pbozeman/artix-unplugged/README.md

# Artix Unplugged

Bare Artix-7 with all the IO pins exposed.
