pbozeman/artix-unplugged/docs/programming.md

# Programming

## Flash

Supported flash memory: see <https://docs.amd.com/r/en-US/ug908-vivado-programming-debugging/Artix-7-Configuration-Memory-Devices>

> Decision: MX25L3233F
