pbozeman/artix-unplugged/pcb/aup/aup.kicad_pcb

## KiCad design pcb/aup/aup.kicad_pcb (2025-06-10)

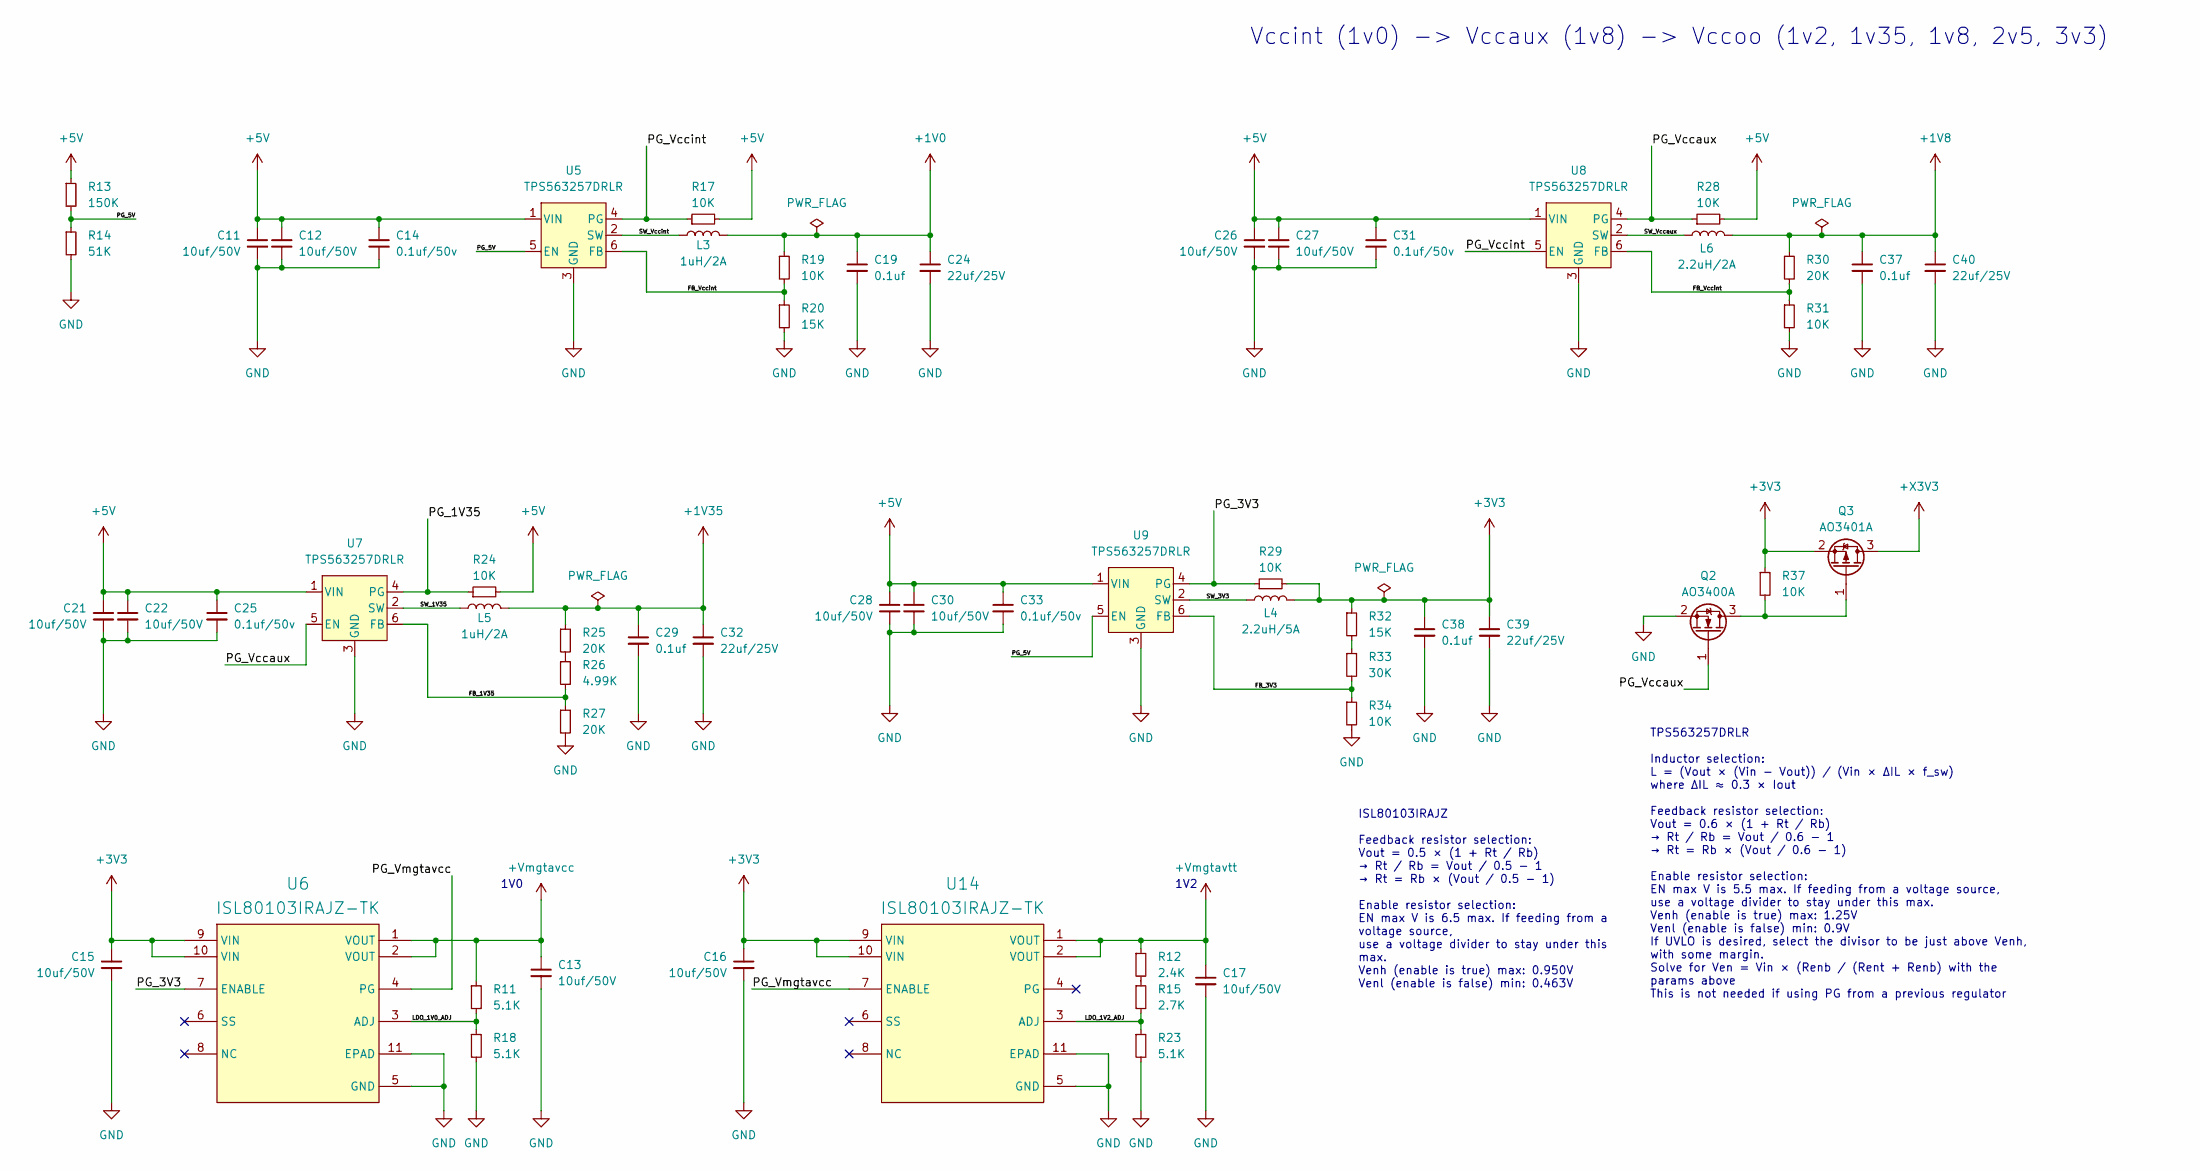
[picture p1: schematic power_reg.kicad_sch, Power Regulation]

Parts:
C11, C12, C13, C15, C16, C17, C21, C22, C26, C27, C28, C30: 10uf/50V; C_0805_2012Metric; LCSC Part # C440198
C14, C25, C31, C33: 0.1uf/50v; C_0603_1608Metric; LCSC Part # C14663
C19, C29, C37, C38: 0.1uf; C_0402_1005Metric; LCSC Part # C1525
C24, C32, C39, C40: 22uf/25V; C_0805_2012Metric; LCSC Part # C45783
L3, L5: 1uH/2A; L_1008_2520Metric; LCSC Part # C435392
L4: 2.2uH/5A; L_Sunlord_MWSA0518S; LCSC Part # C408345
L6: 2.2uH/2A; L_1008_2520Metric; LCSC Part # C576403
Q2: AO3400A; SOT-23; LCSC Part # C20917
Q3: AO3401A; SOT-23; LCSC Part # C15127
R11, R18, R23: 5.1K; R_0603_1608Metric; LCSC Part # C23186
R12: 2.4K; R_0603_1608Metric; LCSC Part # C22940
R13: 150K; R_0603_1608Metric; LCSC Part # C22808
R14: 51K; R_0603_1608Metric; LCSC Part # C23196
R15: 2.7K; R_0603_1608Metric; LCSC Part # C25879
R17, R19, R24, R28, R29, R31, R34, R37: 10K; R_0603_1608Metric; LCSC Part # C25804
R20, R32: 15K; R_0603_1608Metric; LCSC Part # C22809
R25, R27, R30: 20K; R_0603_1608Metric; LCSC Part # C4184
R26: 4.99K; R_0603_1608Metric; LCSC Part # C23046
R33: 30K; R_0603_1608Metric; LCSC Part # C22984
U5, U7, U8, U9: TPS563257DRLR; SOT6_DRL_TEX; LCSC Part # C20539656
U6, U14: ISL80103IRAJZ-TK; DFN10_3X3_INR; LCSC Part # C382020

Connections:
+1V0: C19.1, C24.1, L3.2, R19.1; also elsewhere on the board
+1V8: C37.1, C40.1, L6.2, R30.1; also elsewhere on the board
+1V35: C29.1, C32.1, L5.2, R25.1; also elsewhere on the board
+3V3: C15.1, C16.1, C38.1, C39.1, L4.2, Q3.2 (S), R29.2, R32.1, R37.1, U6.9 (VIN), U6.10 (VIN), U14.9 (VIN), U14.10 (VIN); also elsewhere on the board
+5V: C11.1, C12.1, C14.1, C21.1, C22.1, C25.1, C26.1, C27.1, C28.1, C30.1, C31.1, C33.1, R13.1, R17.2, R24.2, R28.2, U5.1 (VIN), U7.1 (VIN), U8.1 (VIN), U9.1 (VIN); also elsewhere on the board
+Vmgtavcc: C13.1, R11.1, U6.1 (VOUT), U6.2 (VOUT); also elsewhere on the board
+Vmgtavtt: C17.1, R12.1, U14.1 (VOUT), U14.2 (VOUT); also elsewhere on the board
+X3V3: Q3.3 (D)
/power_reg/FB_1V35: R26.2, R27.1, U7.6 (FB)
/power_reg/FB_3V3: R33.2, R34.1, U9.6 (FB)
/power_reg/FB_Vccint: R19.2, R20.1, R30.2, R31.1, U5.6 (FB), U8.6 (FB)
/power_reg/LDO_1V0_ADJ: R11.2, R18.1, U6.3 (ADJ)
/power_reg/LDO_1V2_ADJ: R15.2, R23.1, U14.3 (ADJ)
/power_reg/PG_1V35: R24.1, U7.4 (PG)
/power_reg/PG_3V3: R29.1, U6.7 (ENABLE), U9.4 (PG)
/power_reg/PG_5V: R13.2, R14.1, U5.5 (EN), U9.5 (EN)
/power_reg/PG_Vccaux: Q2.1 (G), R28.1, U7.5 (EN), U8.4 (PG)
/power_reg/PG_Vccint: R17.1, U5.4 (PG), U8.5 (EN)
/power_reg/PG_Vmgtavcc: U6.4 (PG), U14.7 (ENABLE)
/power_reg/SW_1V35: L5.1, U7.2 (SW)
/power_reg/SW_3V3: L4.1, U9.2 (SW)
/power_reg/SW_Vccaux: L6.1, U8.2 (SW)
/power_reg/SW_Vccint: L3.1, U5.2 (SW)
GND: C11.2, C12.2, C13.2, C14.2, C15.2, C16.2, C17.2, C19.2, C21.2, C22.2, C24.2, C25.2, C26.2, C27.2, C28.2, C29.2, C30.2, C31.2, C32.2, C33.2, C37.2, C38.2, C39.2, C40.2, Q2.2 (S), R14.2, R18.2, R20.2, R23.2, R27.2, R31.2, R34.2, U5.3 (GND), U6.5 (GND), U6.11 (EPAD), U7.3 (GND), U8.3 (GND), U9.3 (GND), U14.5 (GND), U14.11 (EPAD); also elsewhere on the board
unnamed: Q2.3 (D), Q3.1 (G), R37.2
unnamed: R12.2, R15.1
unnamed: R25.2, R26.1
unnamed: R32.2, R33.1

Notes on the sheet:
Vccint (1v0) -> Vccaux (1v8) -> Vccoo (1v2, 1v35, 1v8, 2v5, 3v3)
1V2
1V0
TPS563257DRLR Inductor selection: L = (Vout × (Vin - Vout)) / (Vin × ΔIL × f_sw) where ΔIL ≈ 0.3 × Iout Feedback resistor selection: Vout = 0.6 × (1 + Rt / Rb) → Rt / Rb = Vout / 0.6 - 1 → Rt = Rb × (Vout / 0.6 - 1) Enable resistor selection: EN max V is 5.5 max. If feeding from a voltage source, u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
ISL80103IRAJZ Feedback resistor selection: Vout = 0.5 × (1 + Rt / Rb) → Rt / Rb = Vout / 0.5 - 1 → Rt = Rb × (Vout / 0.5 - 1) Enable resistor selection: EN max V is 6.5 max. If feeding from a voltage source, use a voltage divider to stay under this max. Venh (enable is true) max: 0.950V Venl (enabl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

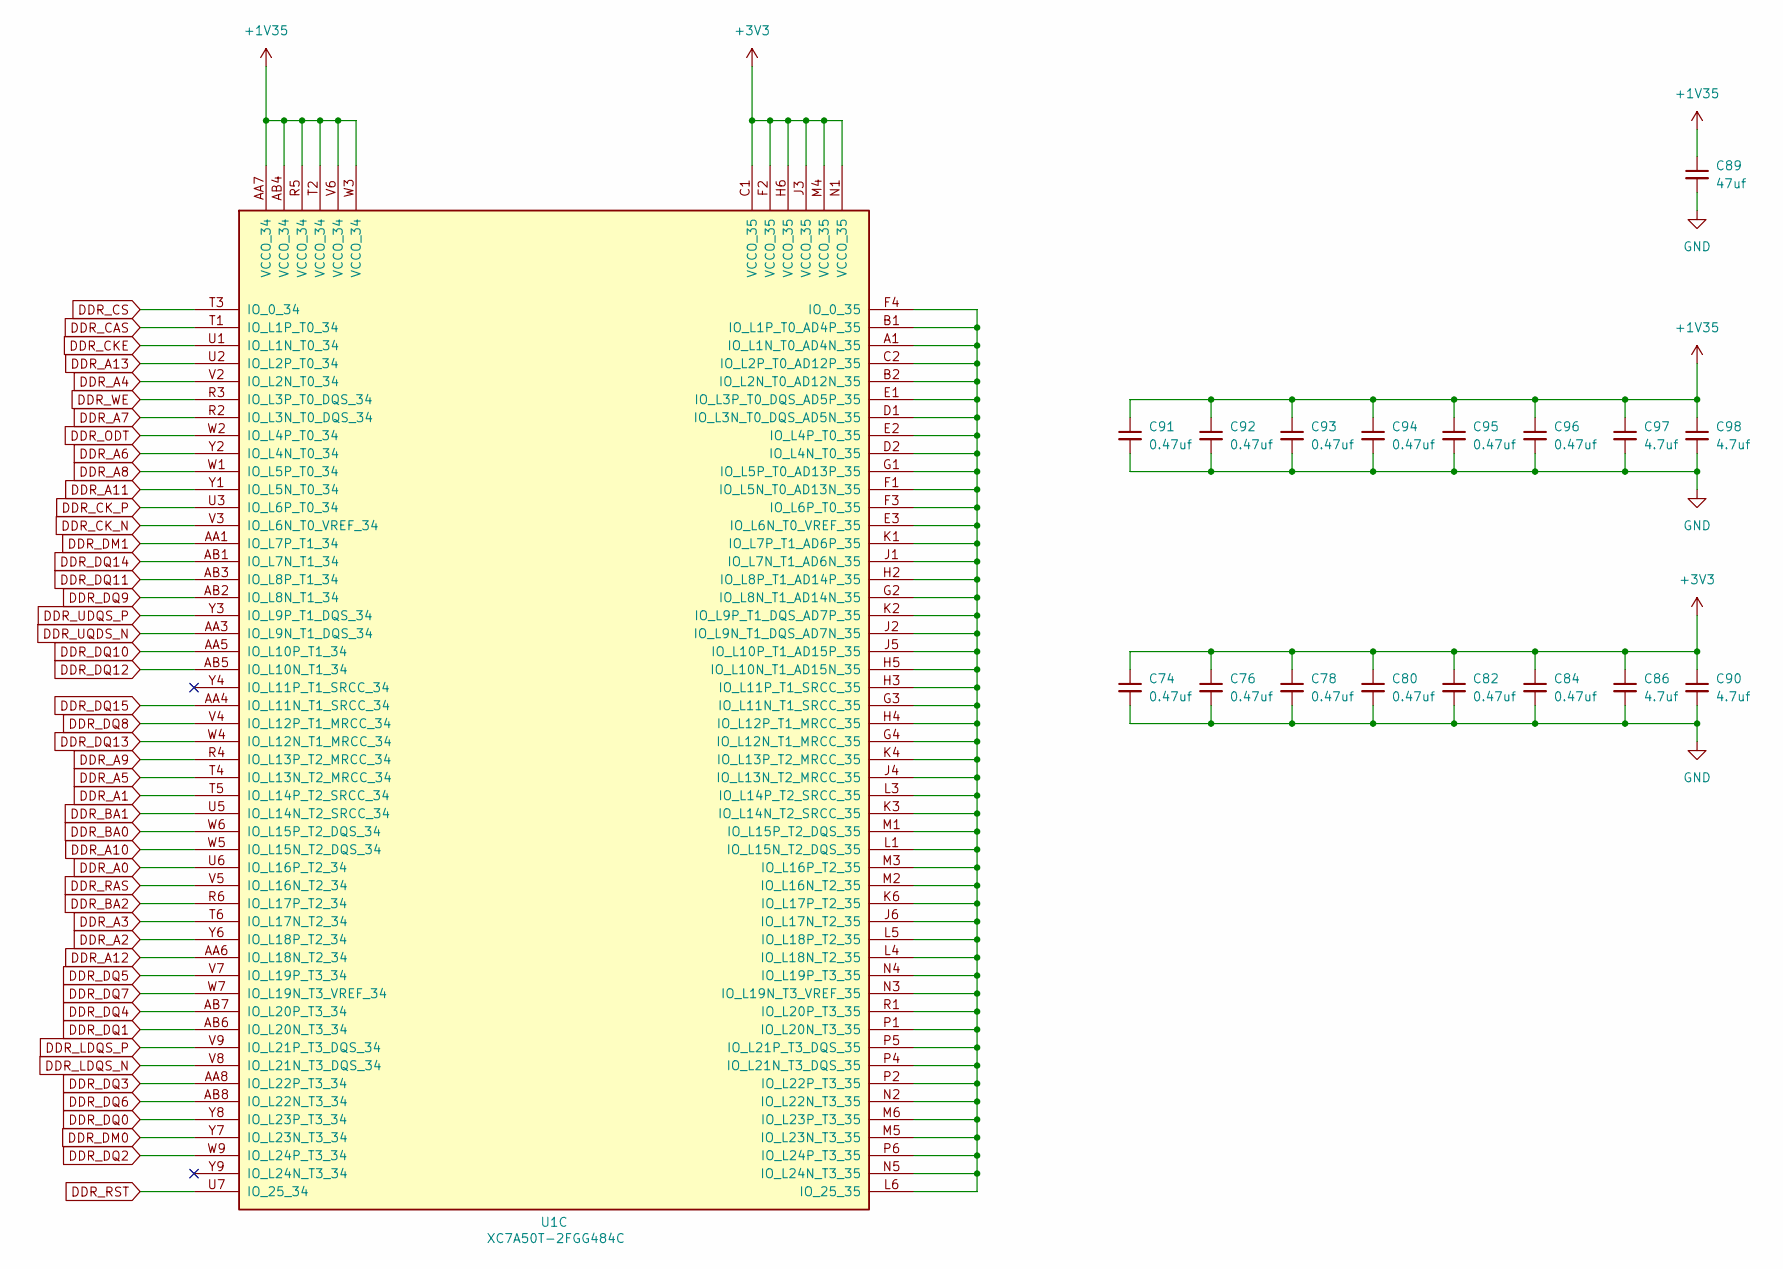
[picture p2: schematic fpga_banks_34_35.kicad_sch]

Parts:
C74, C76, C78, C80, C82, C84, C91, C92, C93, C94, C95, C96: 0.47uf; C_0201_0603Metric; LCSC Part # C318543
C86, C90, C97, C98: 4.7uf; C_0805_2012Metric; LCSC Part # C1779
C89: 47uf; C_1206_3216Metric; LCSC Part # C96123
U1: XC7A50T-2FGG484C; Xilinx_FGG484; LCSC Part # C1550658

Connections:
+1V35: C89.1, C91.1, C92.1, C93.1, C94.1, C95.1, C96.1, C97.1, C98.1, U1.AA7 (VCCO_34), U1.AB4 (VCCO_34), U1.R5 (VCCO_34), U1.T2 (VCCO_34), U1.V6 (VCCO_34), U1.W3 (VCCO_34); also elsewhere on the board
+3V3: C74.1, C76.1, C78.1, C80.1, C82.1, C84.1, C86.1, C90.1, U1.C1 (VCCO_35), U1.F2 (VCCO_35), U1.H6 (VCCO_35), U1.J3 (VCCO_35), U1.M4 (VCCO_35), U1.N1 (VCCO_35); also elsewhere on the board
DDR_A0: U1.U6 (IO_L16P_T2_34); also elsewhere on the board
DDR_A1: U1.T5 (IO_L14P_T2_SRCC_34); also elsewhere on the board
DDR_A2: U1.Y6 (IO_L18P_T2_34); also elsewhere on the board
DDR_A3: U1.T6 (IO_L17N_T2_34); also elsewhere on the board
DDR_A4: U1.V2 (IO_L2N_T0_34); also elsewhere on the board
DDR_A5: U1.T4 (IO_L13N_T2_MRCC_34); also elsewhere on the board
DDR_A6: U1.Y2 (IO_L4N_T0_34); also elsewhere on the board
DDR_A7: U1.R2 (IO_L3N_T0_DQS_34); also elsewhere on the board
DDR_A8: U1.W1 (IO_L5P_T0_34); also elsewhere on the board
DDR_A9: U1.R4 (IO_L13P_T2_MRCC_34); also elsewhere on the board
DDR_A10: U1.W5 (IO_L15N_T2_DQS_34); also elsewhere on the board
DDR_A11: U1.Y1 (IO_L5N_T0_34); also elsewhere on the board
DDR_A12: U1.AA6 (IO_L18N_T2_34); also elsewhere on the board
DDR_A13: U1.U2 (IO_L2P_T0_34); also elsewhere on the board
DDR_BA0: U1.W6 (IO_L15P_T2_DQS_34); also elsewhere on the board
DDR_BA1: U1.U5 (IO_L14N_T2_SRCC_34); also elsewhere on the board
DDR_BA2: U1.R6 (IO_L17P_T2_34); also elsewhere on the board
DDR_CAS: U1.T1 (IO_L1P_T0_34); also elsewhere on the board
DDR_CKE: U1.U1 (IO_L1N_T0_34); also elsewhere on the board
DDR_CK_N: U1.V3 (IO_L6N_T0_VREF_34); also elsewhere on the board
DDR_CK_P: U1.U3 (IO_L6P_T0_34); also elsewhere on the board
DDR_CS: U1.T3 (IO_0_34); also elsewhere on the board
DDR_DM0: U1.Y7 (IO_L23N_T3_34); also elsewhere on the board
DDR_DM1: U1.AA1 (IO_L7P_T1_34); also elsewhere on the board
DDR_DQ0: U1.Y8 (IO_L23P_T3_34); also elsewhere on the board
DDR_DQ1: U1.AB6 (IO_L20N_T3_34); also elsewhere on the board
DDR_DQ2: U1.W9 (IO_L24P_T3_34); also elsewhere on the board
DDR_DQ3: U1.AA8 (IO_L22P_T3_34); also elsewhere on the board
DDR_DQ4: U1.AB7 (IO_L20P_T3_34); also elsewhere on the board
DDR_DQ5: U1.V7 (IO_L19P_T3_34); also elsewhere on the board
DDR_DQ6: U1.AB8 (IO_L22N_T3_34); also elsewhere on the board
DDR_DQ7: U1.W7 (IO_L19N_T3_VREF_34); also elsewhere on the board
DDR_DQ8: U1.V4 (IO_L12P_T1_MRCC_34); also elsewhere on the board
DDR_DQ9: U1.AB2 (IO_L8N_T1_34); also elsewhere on the board
DDR_DQ10: U1.AA5 (IO_L10P_T1_34); also elsewhere on the board
DDR_DQ11: U1.AB3 (IO_L8P_T1_34); also elsewhere on the board
DDR_DQ12: U1.AB5 (IO_L10N_T1_34); also elsewhere on the board
DDR_DQ13: U1.W4 (IO_L12N_T1_MRCC_34); also elsewhere on the board
DDR_DQ14: U1.AB1 (IO_L7N_T1_34); also elsewhere on the board
DDR_DQ15: U1.AA4 (IO_L11N_T1_SRCC_34); also elsewhere on the board
DDR_LDQS_N: U1.V8 (IO_L21N_T3_DQS_34); also elsewhere on the board
DDR_LDQS_P: U1.V9 (IO_L21P_T3_DQS_34); also elsewhere on the board
DDR_ODT: U1.W2 (IO_L4P_T0_34); also elsewhere on the board
DDR_RAS: U1.V5 (IO_L16N_T2_34); also elsewhere on the board
DDR_RST: U1.U7 (IO_25_34); also elsewhere on the board
DDR_UDQS_P: U1.Y3 (IO_L9P_T1_DQS_34); also elsewhere on the board
DDR_UQDS_N: U1.AA3 (IO_L9N_T1_DQS_34); also elsewhere on the board
DDR_WE: U1.R3 (IO_L3P_T0_DQS_34); also elsewhere on the board
GND: C74.2, C76.2, C78.2, C80.2, C82.2, C84.2, C86.2, C89.2, C90.2, C91.2, C92.2, C93.2, C94.2, C95.2, C96.2, C97.2, C98.2; also elsewhere on the board
unnamed: U1.A1 (IO_L1N_T0_AD4N_35), U1.B1 (IO_L1P_T0_AD4P_35), U1.B2 (IO_L2N_T0_AD12N_35), U1.C2 (IO_L2P_T0_AD12P_35), U1.D1 (IO_L3N_T0_DQS_AD5N_35), U1.D2 (IO_L4N_T0_35), U1.E1 (IO_L3P_T0_DQS_AD5P_35), U1.E2 (IO_L4P_T0_35), U1.E3 (IO_L6N_T0_VREF_35), U1.F1 (IO_L5N_T0_AD13N_35), U1.F3 (IO_L6P_T0_35), U1.F4 (IO_0_35), U1.G1 (IO_L5P_T0_AD13P_35), U1.G2 (IO_L8N_T1_AD14N_35), U1.G3 (IO_L11N_T1_SRCC_35), U1.G4 (IO_L12N_T1_MRCC_35), U1.H2 (IO_L8P_T1_AD14P_35), U1.H3 (IO_L11P_T1_SRCC_35), U1.H4 (IO_L12P_T1_MRCC_35), U1.H5 (IO_L10N_T1_AD15N_35), U1.J1 (IO_L7N_T1_AD6N_35), U1.J2 (IO_L9N_T1_DQS_AD7N_35), U1.J4 (IO_L13N_T2_MRCC_35), U1.J5 (IO_L10P_T1_AD15P_35), U1.J6 (IO_L17N_T2_35), U1.K1 (IO_L7P_T1_AD6P_35), U1.K2 (IO_L9P_T1_DQS_AD7P_35), U1.K3 (IO_L14N_T2_SRCC_35), U1.K4 (IO_L13P_T2_MRCC_35), U1.K6 (IO_L17P_T2_35), U1.L1 (IO_L15N_T2_DQS_35), U1.L3 (IO_L14P_T2_SRCC_35), U1.L4 (IO_L18N_T2_35), U1.L5 (IO_L18P_T2_35), U1.L6 (IO_25_35), U1.M1 (IO_L15P_T2_DQS_35), U1.M2 (IO_L16N_T2_35), U1.M3 (IO_L16P_T2_35), U1.M5 (IO_L23N_T3_35), U1.M6 (IO_L23P_T3_35), U1.N2 (IO_L22N_T3_35), U1.N3 (IO_L19N_T3_VREF_35), U1.N4 (IO_L19P_T3_35), U1.N5 (IO_L24N_T3_35), U1.P1 (IO_L20N_T3_35), U1.P2 (IO_L22P_T3_35), U1.P4 (IO_L21N_T3_DQS_35), U1.P5 (IO_L21P_T3_DQS_35), U1.P6 (IO_L24P_T3_35), U1.R1 (IO_L20P_T3_35)

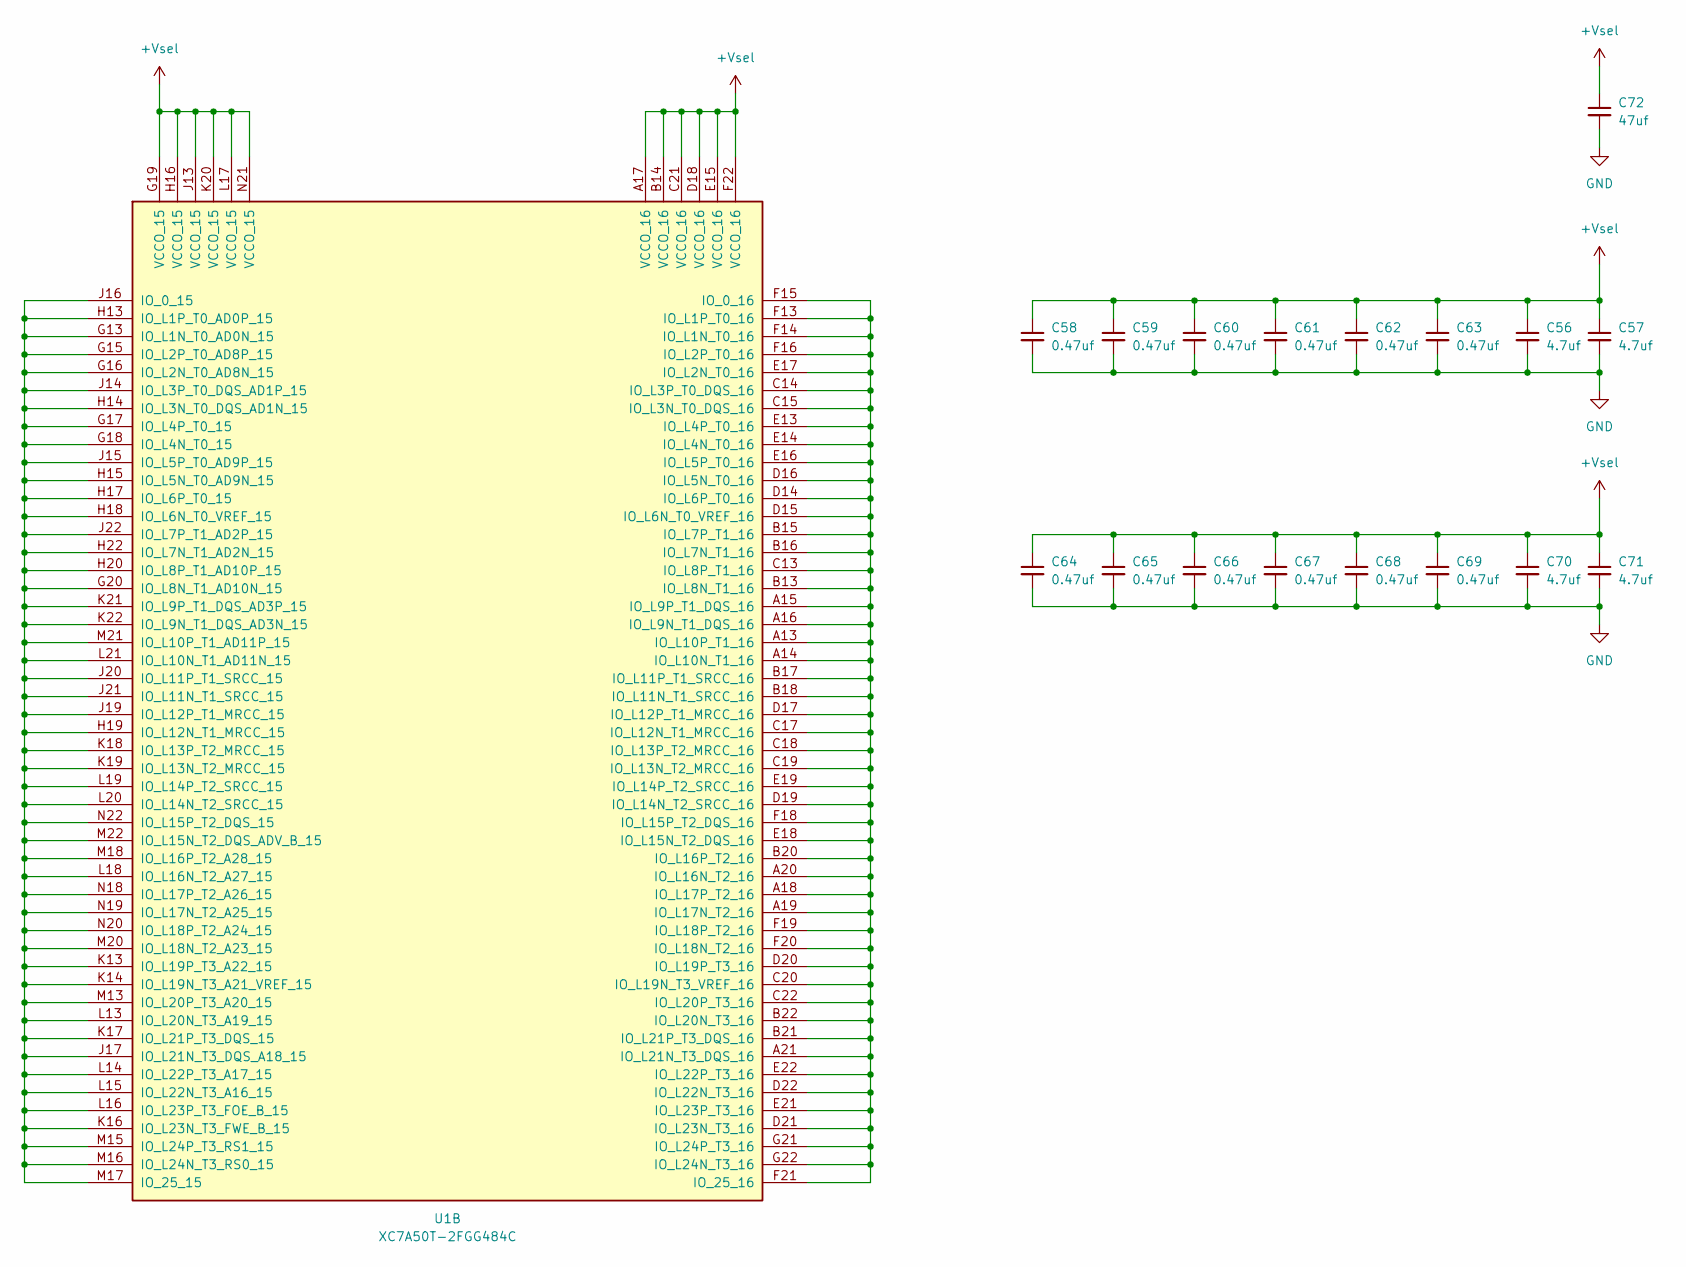
[picture p3: schematic fpga_banks_15_16_adj.kicad_sch]

Parts:
C56, C57, C70, C71: 4.7uf; C_0805_2012Metric; LCSC Part # C1779
C58, C59, C60, C61, C62, C63, C64, C65, C66, C67, C68, C69: 0.47uf; C_0201_0603Metric; LCSC Part # C318543
C72: 47uf; C_1206_3216Metric; LCSC Part # C96123
U1: XC7A50T-2FGG484C; Xilinx_FGG484; LCSC Part # C1550658

Connections:
+Vsel: C56.1, C57.1, C58.1, C59.1, C60.1, C61.1, C62.1, C63.1, C64.1, C65.1, C66.1, C67.1, C68.1, C69.1, C70.1, C71.1, C72.1, U1.A17 (VCCO_16), U1.B14 (VCCO_16), U1.C21 (VCCO_16), U1.D18 (VCCO_16), U1.E15 (VCCO_16), U1.F22 (VCCO_16), U1.G19 (VCCO_15), U1.H16 (VCCO_15), U1.J13 (VCCO_15), U1.K20 (VCCO_15), U1.L17 (VCCO_15), U1.N21 (VCCO_15); also elsewhere on the board
GND: C56.2, C57.2, C58.2, C59.2, C60.2, C61.2, C62.2, C63.2, C64.2, C65.2, C66.2, C67.2, C68.2, C69.2, C70.2, C71.2, C72.2; also elsewhere on the board
unnamed: U1.G13 (IO_L1N_T0_AD0N_15), U1.G15 (IO_L2P_T0_AD8P_15), U1.G16 (IO_L2N_T0_AD8N_15), U1.G17 (IO_L4P_T0_15), U1.G18 (IO_L4N_T0_15), U1.G20 (IO_L8N_T1_AD10N_15), U1.H13 (IO_L1P_T0_AD0P_15), U1.H14 (IO_L3N_T0_DQS_AD1N_15), U1.H15 (IO_L5N_T0_AD9N_15), U1.H17 (IO_L6P_T0_15), U1.H18 (IO_L6N_T0_VREF_15), U1.H19 (IO_L12N_T1_MRCC_15), U1.H20 (IO_L8P_T1_AD10P_15), U1.H22 (IO_L7N_T1_AD2N_15), U1.J14 (IO_L3P_T0_DQS_AD1P_15), U1.J15 (IO_L5P_T0_AD9P_15), U1.J16 (IO_0_15), U1.J17 (IO_L21N_T3_DQS_A18_15), U1.J19 (IO_L12P_T1_MRCC_15), U1.J20 (IO_L11P_T1_SRCC_15), U1.J21 (IO_L11N_T1_SRCC_15), U1.J22 (IO_L7P_T1_AD2P_15), U1.K13 (IO_L19P_T3_A22_15), U1.K14 (IO_L19N_T3_A21_VREF_15), U1.K16 (IO_L23N_T3_FWE_B_15), U1.K17 (IO_L21P_T3_DQS_15), U1.K18 (IO_L13P_T2_MRCC_15), U1.K19 (IO_L13N_T2_MRCC_15), U1.K21 (IO_L9P_T1_DQS_AD3P_15), U1.K22 (IO_L9N_T1_DQS_AD3N_15), U1.L13 (IO_L20N_T3_A19_15), U1.L14 (IO_L22P_T3_A17_15), U1.L15 (IO_L22N_T3_A16_15), U1.L16 (IO_L23P_T3_FOE_B_15), U1.L18 (IO_L16N_T2_A27_15), U1.L19 (IO_L14P_T2_SRCC_15), U1.L20 (IO_L14N_T2_SRCC_15), U1.L21 (IO_L10N_T1_AD11N_15), U1.M13 (IO_L20P_T3_A20_15), U1.M15 (IO_L24P_T3_RS1_15), U1.M16 (IO_L24N_T3_RS0_15), U1.M17 (IO_25_15), U1.M18 (IO_L16P_T2_A28_15), U1.M20 (IO_L18N_T2_A23_15), U1.M21 (IO_L10P_T1_AD11P_15), U1.M22 (IO_L15N_T2_DQS_ADV_B_15), U1.N18 (IO_L17P_T2_A26_15), U1.N19 (IO_L17N_T2_A25_15), U1.N20 (IO_L18P_T2_A24_15), U1.N22 (IO_L15P_T2_DQS_15)
unnamed: U1.A13 (IO_L10P_T1_16), U1.A14 (IO_L10N_T1_16), U1.A15 (IO_L9P_T1_DQS_16), U1.A16 (IO_L9N_T1_DQS_16), U1.A18 (IO_L17P_T2_16), U1.A19 (IO_L17N_T2_16), U1.A20 (IO_L16N_T2_16), U1.A21 (IO_L21N_T3_DQS_16), U1.B13 (IO_L8N_T1_16), U1.B15 (IO_L7P_T1_16), U1.B16 (IO_L7N_T1_16), U1.B17 (IO_L11P_T1_SRCC_16), U1.B18 (IO_L11N_T1_SRCC_16), U1.B20 (IO_L16P_T2_16), U1.B21 (IO_L21P_T3_DQS_16), U1.B22 (IO_L20N_T3_16), U1.C13 (IO_L8P_T1_16), U1.C14 (IO_L3P_T0_DQS_16), U1.C15 (IO_L3N_T0_DQS_16), U1.C17 (IO_L12N_T1_MRCC_16), U1.C18 (IO_L13P_T2_MRCC_16), U1.C19 (IO_L13N_T2_MRCC_16), U1.C20 (IO_L19N_T3_VREF_16), U1.C22 (IO_L20P_T3_16), U1.D14 (IO_L6P_T0_16), U1.D15 (IO_L6N_T0_VREF_16), U1.D16 (IO_L5N_T0_16), U1.D17 (IO_L12P_T1_MRCC_16), U1.D19 (IO_L14N_T2_SRCC_16), U1.D20 (IO_L19P_T3_16), U1.D21 (IO_L23N_T3_16), U1.D22 (IO_L22N_T3_16), U1.E13 (IO_L4P_T0_16), U1.E14 (IO_L4N_T0_16), U1.E16 (IO_L5P_T0_16), U1.E17 (IO_L2N_T0_16), U1.E18 (IO_L15N_T2_DQS_16), U1.E19 (IO_L14P_T2_SRCC_16), U1.E21 (IO_L23P_T3_16), U1.E22 (IO_L22P_T3_16), U1.F13 (IO_L1P_T0_16), U1.F14 (IO_L1N_T0_16), U1.F15 (IO_0_16), U1.F16 (IO_L2P_T0_16), U1.F18 (IO_L15P_T2_DQS_16), U1.F19 (IO_L18P_T2_16), U1.F20 (IO_L18N_T2_16), U1.F21 (IO_25_16), U1.G21 (IO_L24P_T3_16), U1.G22 (IO_L24N_T3_16)

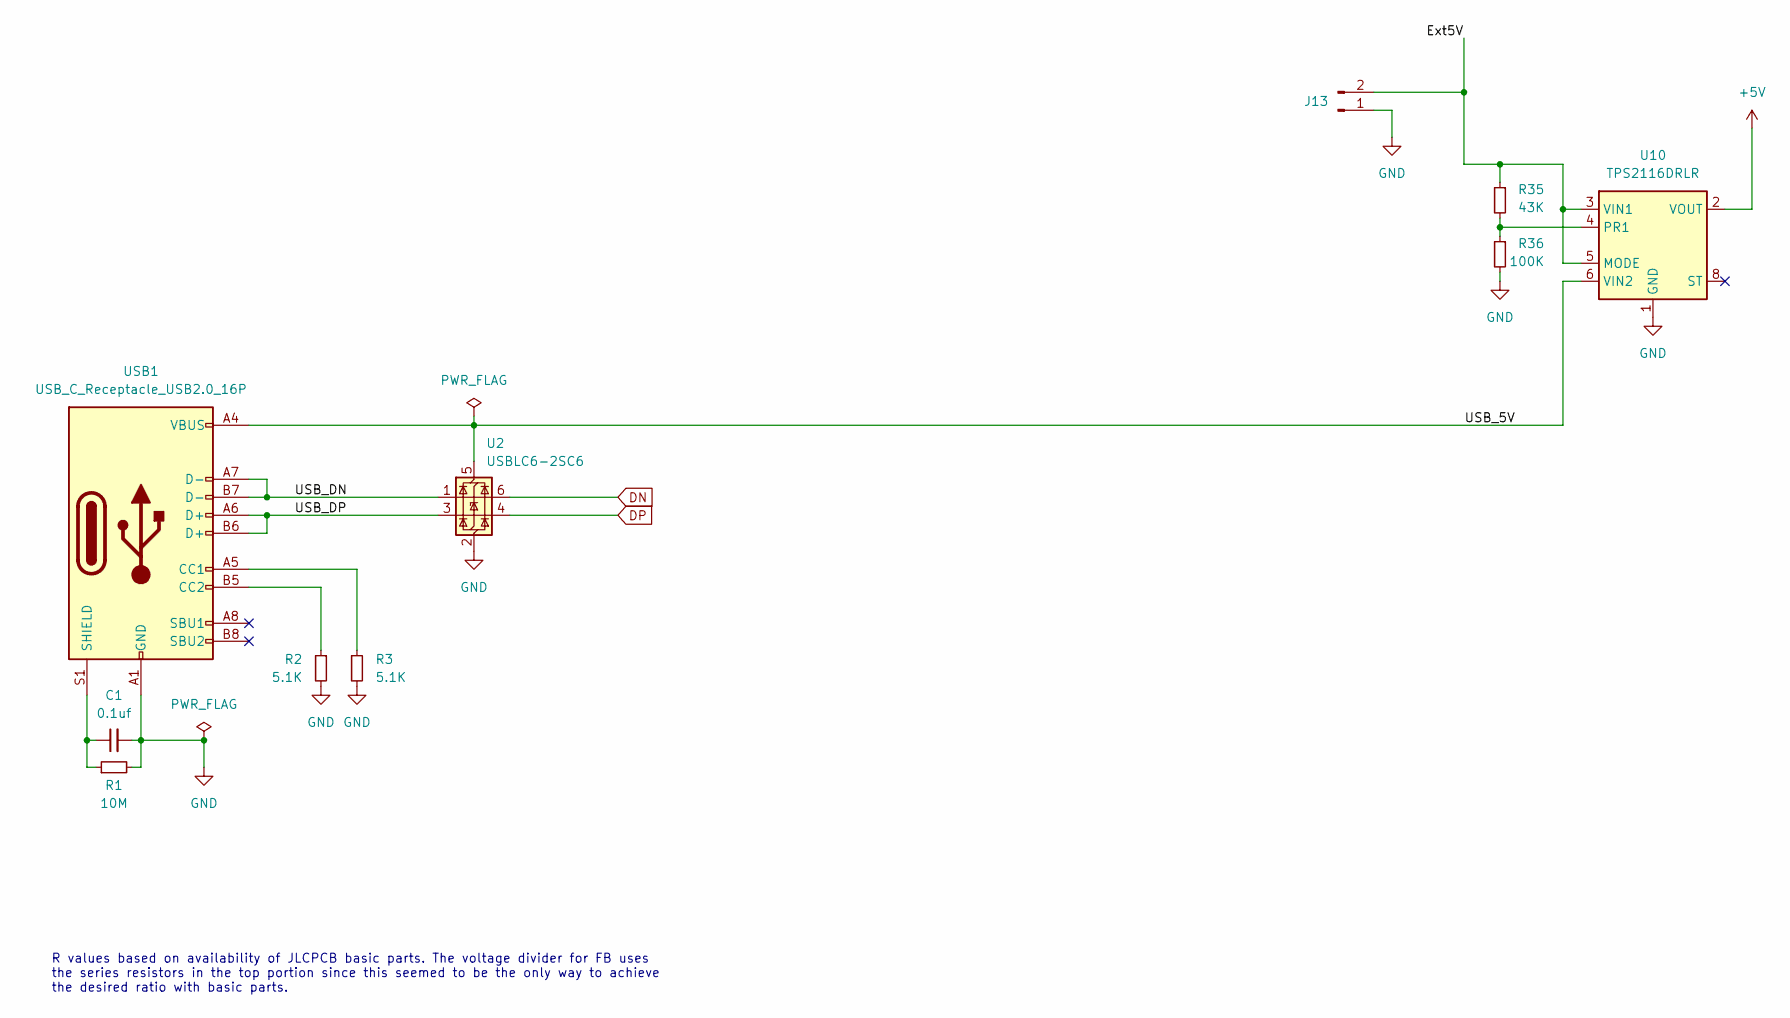
[picture p4: schematic ext_power.kicad_sch, External Power]

Parts:
C1: 0.1uf; C_0402_1005Metric; LCSC Part # C1525
J13: Conn_01x02_Pin
R1: 10M; R_0603_1608Metric; LCSC Part # C7250
R2, R3: 5.1K; R_0603_1608Metric; LCSC Part # C23186
R35: 43K; R_0603_1608Metric; LCSC Part # C23172
R36: 100K; R_0603_1608Metric; LCSC Part # C25803
U2: USBLC6-2SC6; SOT-23-6; LCSC Part # C7519
U10: TPS2116DRLR; SOT-583-8; LCSC Part # C3235557
USB1: USB_C_Receptacle_USB2.0_16P; USB_C_Receptacle_GCT_USB4105-xx-A_16P_TopMnt_Horizontal; LCSC Part # C2686968

Connections:
+5V: U10.2 (VOUT), U10.7 (VOUT); also elsewhere on the board
/ext_power/Ext5V: J13.2, R35.1, U10.3 (VIN1), U10.5 (MODE)
/ext_power/USB_5V: U2.5 (VBUS), U10.6 (VIN2), USB1.A4 (VBUS), USB1.A9 (VBUS), USB1.B4 (VBUS), USB1.B9 (VBUS)
/ext_power/USB_DN: U2.1 (I/O1), USB1.A7 (D-), USB1.B7 (D-)
/ext_power/USB_DP: U2.3 (I/O2), USB1.A6 (D+), USB1.B6 (D+)
DN: U2.6 (I/O1)
DP: U2.4 (I/O2)
GND: C1.2, J13.1, R1.2, R2.2, R3.2, R36.2, U2.2 (GND), U10.1 (GND), USB1.A1 (GND), USB1.A12 (GND), USB1.B1 (GND), USB1.B12 (GND); also elsewhere on the board
unnamed: R35.2, R36.1, U10.4 (PR1)
unnamed: R3.1, USB1.A5 (CC1)
unnamed: R2.1, USB1.B5 (CC2)
unnamed: C1.1, R1.1, USB1.S1 (SHIELD)

Notes on the sheet:
R values based on availability of JLCPCB basic parts. The voltage divider for FB uses the series resistors in the top portion since this seemed to be the only way to achieve the desired ratio with basic parts.

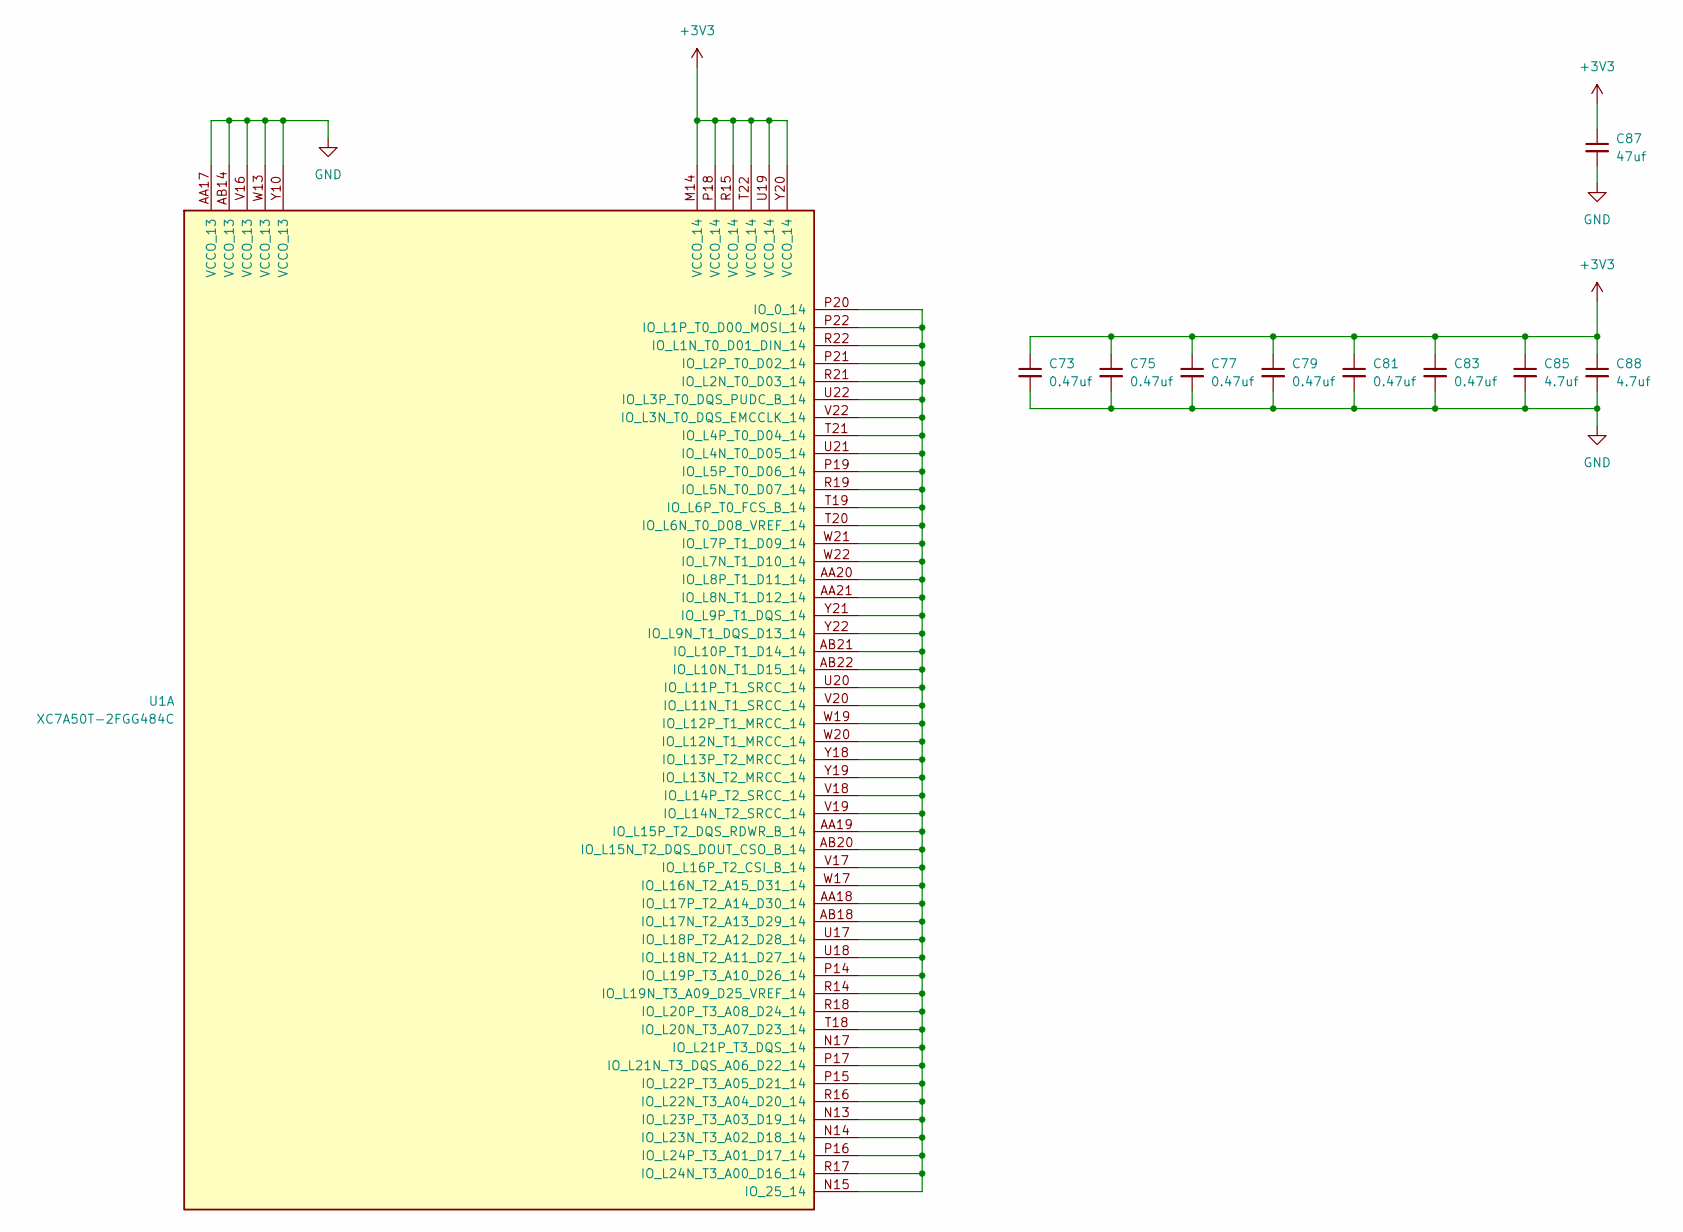
[picture p5: schematic fpga_banks_13_14.kicad_sch]

Parts:
C73, C75, C77, C79, C81, C83: 0.47uf; C_0201_0603Metric; LCSC Part # C318543
C85, C88: 4.7uf; C_0805_2012Metric; LCSC Part # C1779
C87: 47uf; C_1206_3216Metric; LCSC Part # C96123
U1: XC7A50T-2FGG484C; Xilinx_FGG484; LCSC Part # C1550658

Connections:
+3V3: C73.1, C75.1, C77.1, C79.1, C81.1, C83.1, C85.1, C87.1, C88.1, U1.M14 (VCCO_14), U1.P18 (VCCO_14), U1.R15 (VCCO_14), U1.T22 (VCCO_14), U1.U19 (VCCO_14), U1.Y20 (VCCO_14); also elsewhere on the board
GND: C73.2, C75.2, C77.2, C79.2, C81.2, C83.2, C85.2, C87.2, C88.2, U1.AA17 (VCCO_13), U1.AB14 (VCCO_13), U1.V16 (VCCO_13), U1.W13 (VCCO_13), U1.Y10 (VCCO_13); also elsewhere on the board
unnamed: U1.AA18 (IO_L17P_T2_A14_D30_14), U1.AA19 (IO_L15P_T2_DQS_RDWR_B_14), U1.AA20 (IO_L8P_T1_D11_14), U1.AA21 (IO_L8N_T1_D12_14), U1.AB18 (IO_L17N_T2_A13_D29_14), U1.AB20 (IO_L15N_T2_DQS_DOUT_CSO_B_14), U1.AB21 (IO_L10P_T1_D14_14), U1.AB22 (IO_L10N_T1_D15_14), U1.N13 (IO_L23P_T3_A03_D19_14), U1.N14 (IO_L23N_T3_A02_D18_14), U1.N15 (IO_25_14), U1.N17 (IO_L21P_T3_DQS_14), U1.P14 (IO_L19P_T3_A10_D26_14), U1.P15 (IO_L22P_T3_A05_D21_14), U1.P16 (IO_L24P_T3_A01_D17_14), U1.P17 (IO_L21N_T3_DQS_A06_D22_14), U1.P19 (IO_L5P_T0_D06_14), U1.P20 (IO_0_14), U1.P21 (IO_L2P_T0_D02_14), U1.P22 (IO_L1P_T0_D00_MOSI_14), U1.R14 (IO_L19N_T3_A09_D25_VREF_14), U1.R16 (IO_L22N_T3_A04_D20_14), U1.R17 (IO_L24N_T3_A00_D16_14), U1.R18 (IO_L20P_T3_A08_D24_14), U1.R19 (IO_L5N_T0_D07_14), U1.R21 (IO_L2N_T0_D03_14), U1.R22 (IO_L1N_T0_D01_DIN_14), U1.T18 (IO_L20N_T3_A07_D23_14), U1.T19 (IO_L6P_T0_FCS_B_14), U1.T20 (IO_L6N_T0_D08_VREF_14), U1.T21 (IO_L4P_T0_D04_14), U1.U17 (IO_L18P_T2_A12_D28_14), U1.U18 (IO_L18N_T2_A11_D27_14), U1.U20 (IO_L11P_T1_SRCC_14), U1.U21 (IO_L4N_T0_D05_14), U1.U22 (IO_L3P_T0_DQS_PUDC_B_14), U1.V17 (IO_L16P_T2_CSI_B_14), U1.V18 (IO_L14P_T2_SRCC_14), U1.V19 (IO_L14N_T2_SRCC_14), U1.V20 (IO_L11N_T1_SRCC_14), U1.V22 (IO_L3N_T0_DQS_EMCCLK_14), U1.W17 (IO_L16N_T2_A15_D31_14), U1.W19 (IO_L12P_T1_MRCC_14), U1.W20 (IO_L12N_T1_MRCC_14), U1.W21 (IO_L7P_T1_D09_14), U1.W22 (IO_L7N_T1_D10_14), U1.Y18 (IO_L13P_T2_MRCC_14), U1.Y19 (IO_L13N_T2_MRCC_14), U1.Y21 (IO_L9P_T1_DQS_14), U1.Y22 (IO_L9N_T1_DQS_D13_14)
