pbozeman/artix-unplugged/pcb/aup/aup.kicad_pcb

## KiCad design pcb/aup/aup.kicad_pcb (continued)

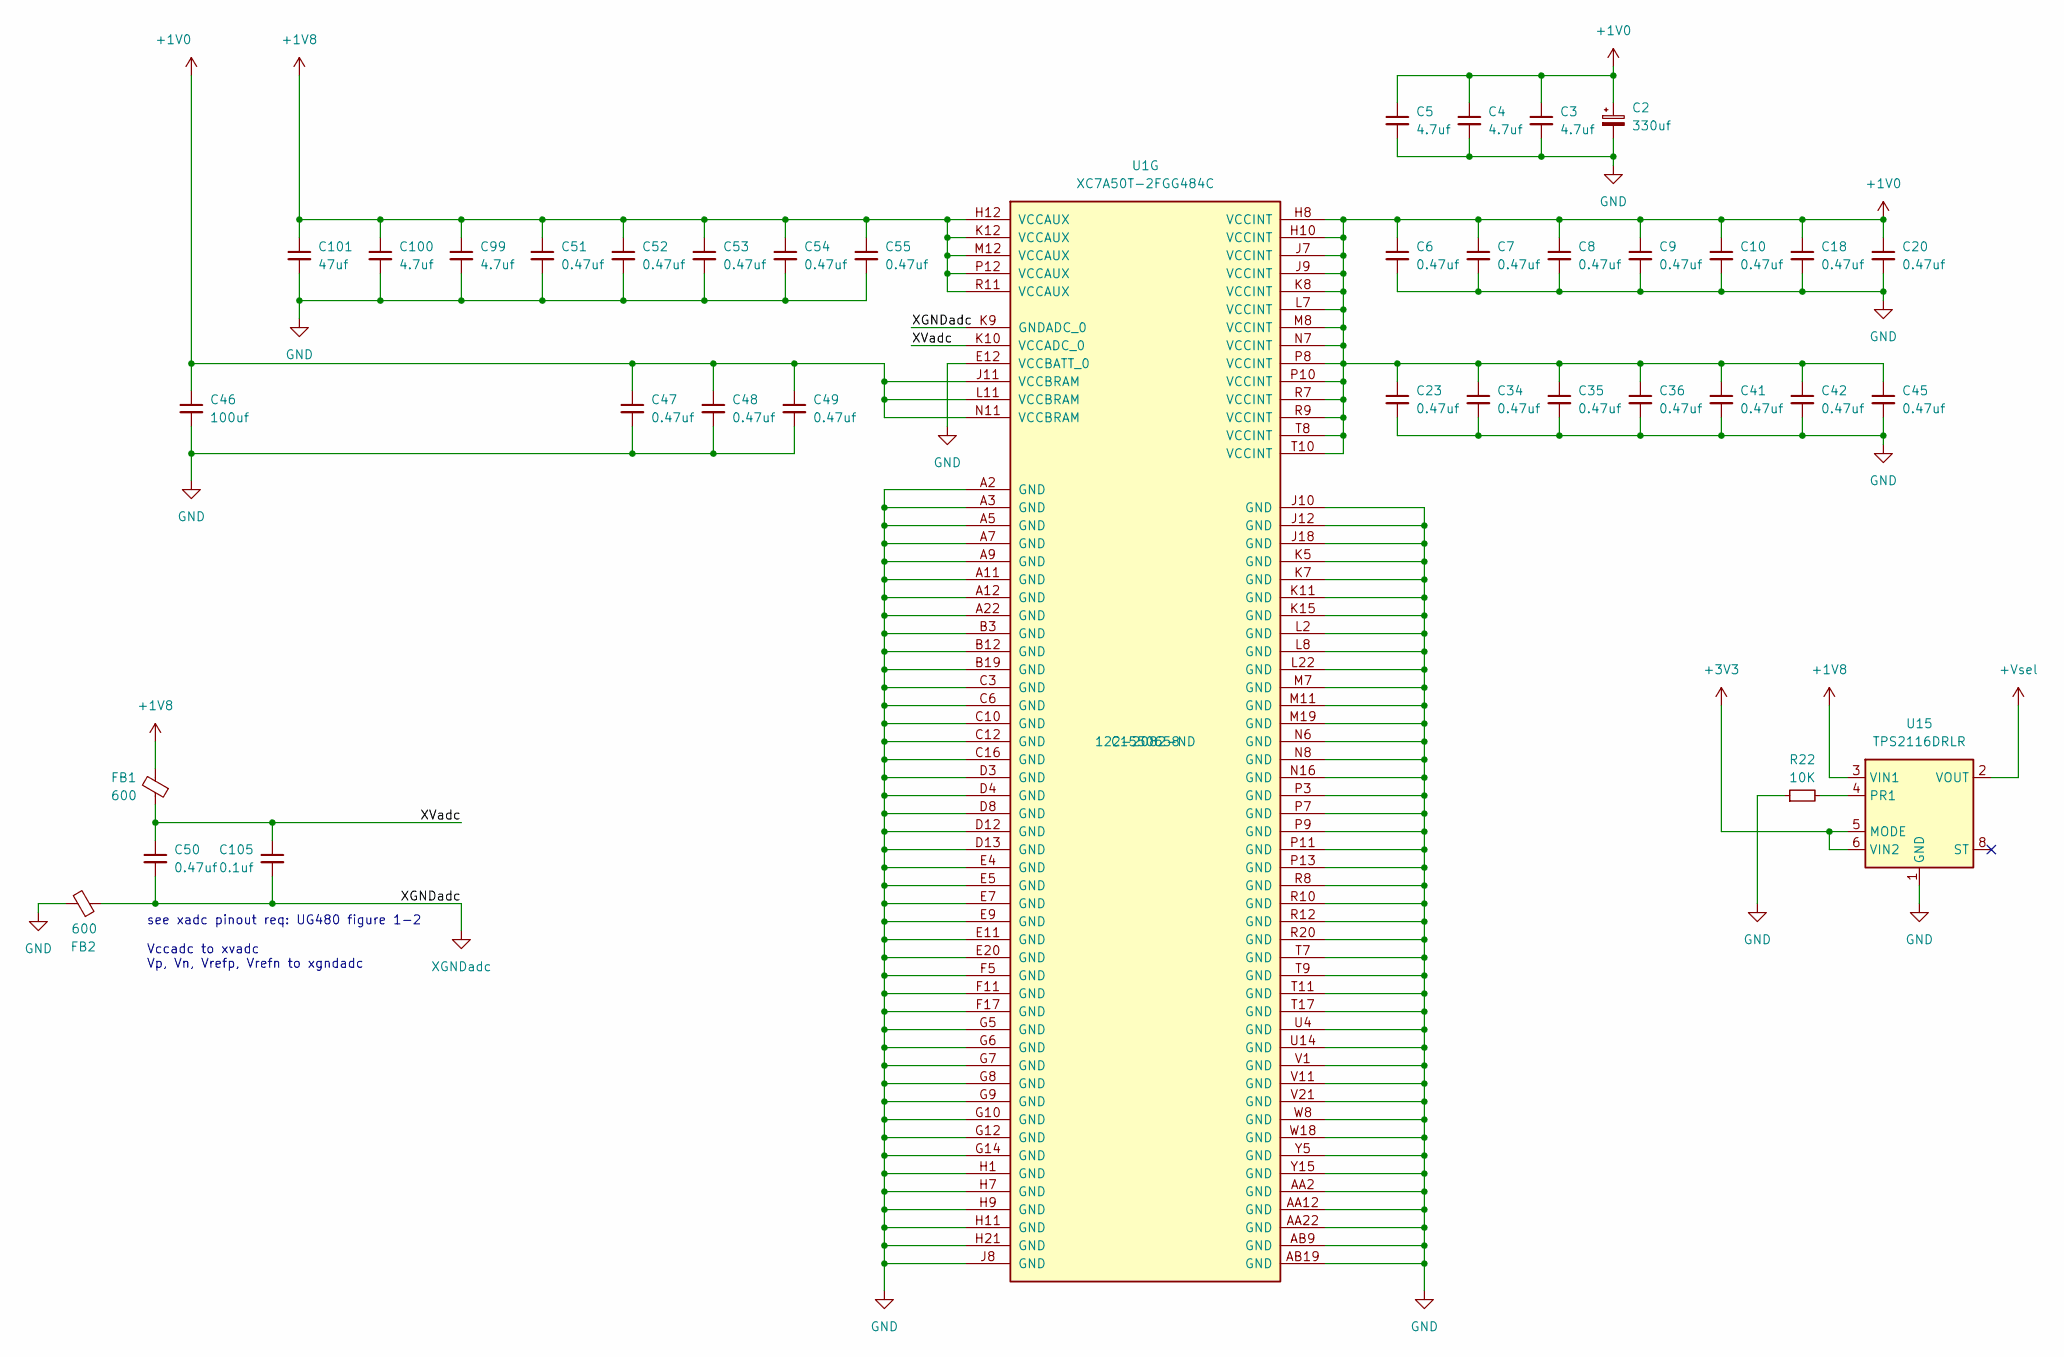
[picture p6: schematic fpga_power.kicad_sch]

Parts:
C2: 330uf; T520V; LCSC Part # C232383
C3, C4, C5, C99, C100: 4.7uf; C_0805_2012Metric; LCSC Part # C1779
C6, C7, C8, C9, C10, C18, C20, C23, C34, C35, C36, C41, C42, C45, C47, C48, C49, C50, C51, C52, C53, C54, C55: 0.47uf; C_0201_0603Metric; LCSC Part # C318543
C46: 100uf; C_1206_3216Metric; LCSC Part # C15008
C101: 47uf; C_1206_3216Metric; LCSC Part # C96123
C105: 0.1uf; C_0402_1005Metric; LCSC Part # C1525
FB1, FB2: 600; L_0402_1005Metric; LCSC Part # C76886
R22: 10K; R_0603_1608Metric; LCSC Part # C25804
U1: XC7A50T-2FGG484C; Xilinx_FGG484; LCSC Part # C1550658
U15: TPS2116DRLR; SOT-583-8; LCSC Part # C3235557

Connections:
+1V0: C2.1, C3.1, C4.1, C5.1, C6.1, C7.1, C8.1, C9.1, C10.1, C18.1, C20.1, C23.1, C34.1, C35.1, C36.1, C41.1, C42.1, C45.1, C46.1, C47.1, C48.1, C49.1, U1.H8 (VCCINT), U1.H10 (VCCINT), U1.J7 (VCCINT), U1.J9 (VCCINT), U1.J11 (VCCBRAM), U1.K8 (VCCINT), U1.L7 (VCCINT), U1.L11 (VCCBRAM), U1.M8 (VCCINT), U1.N7 (VCCINT), U1.N11 (VCCBRAM), U1.P8 (VCCINT), U1.P10 (VCCINT), U1.R7 (VCCINT), U1.R9 (VCCINT), U1.T8 (VCCINT), U1.T10 (VCCINT); also elsewhere on the board
+1V8: C51.1, C52.1, C53.1, C54.1, C55.1, C99.1, C100.1, C101.1, FB1.2, U1.H12 (VCCAUX), U1.K12 (VCCAUX), U1.M12 (VCCAUX), U1.P12 (VCCAUX), U1.R11 (VCCAUX), U15.3 (VIN1); also elsewhere on the board
+3V3: U15.5 (MODE), U15.6 (VIN2); also elsewhere on the board
+Vsel: U15.2 (VOUT), U15.7 (VOUT); also elsewhere on the board
/fpga_power/XVadc: C50.1, C105.1, FB1.1, U1.K10 (VCCADC_0)
GND: C2.2, C3.2, C4.2, C5.2, C6.2, C7.2, C8.2, C9.2, C10.2, C18.2, C20.2, C23.2, C34.2, C35.2, C36.2, C41.2, C42.2, C45.2, C46.2, C47.2, C48.2, C49.2, C51.2, C52.2, C53.2, C54.2, C55.2, C99.2, C100.2, C101.2, FB2.2, R22.1, U1.A2 (GND), U1.A3 (GND), U1.A5 (GND), U1.A7 (GND), U1.A9 (GND), U1.A11 (GND), U1.A12 (GND), U1.A22 (GND), U1.AA2 (GND), U1.AA12 (GND), U1.AA22 (GND), U1.AB9 (GND), U1.AB19 (GND), U1.B3 (GND), U1.B12 (GND), U1.B19 (GND), U1.C3 (GND), U1.C6 (GND), U1.C10 (GND), U1.C12 (GND), U1.C16 (GND), U1.D3 (GND), U1.D4 (GND), U1.D8 (GND), U1.D12 (GND), U1.D13 (GND), U1.E4 (GND), U1.E5 (GND), U1.E7 (GND), U1.E9 (GND), U1.E11 (GND), U1.E12 (VCCBATT_0), U1.E20 (GND), U1.F5 (GND), U1.F11 (GND), U1.F17 (GND), U1.G5 (GND), U1.G6 (GND), U1.G7 (GND), U1.G8 (GND), U1.G9 (GND), U1.G10 (GND), U1.G12 (GND), U1.G14 (GND), U1.H1 (GND), U1.H7 (GND), U1.H9 (GND), U1.H11 (GND), U1.H21 (GND), U1.J8 (GND), U1.J10 (GND), U1.J12 (GND), U1.J18 (GND), U1.K5 (GND), U1.K7 (GND), U1.K11 (GND), U1.K15 (GND), U1.L2 (GND), U1.L8 (GND), U1.L22 (GND), U1.M7 (GND), U1.M11 (GND), U1.M19 (GND), U1.N6 (GND), U1.N8 (GND), U1.N16 (GND), U1.P3 (GND), U1.P7 (GND), U1.P9 (GND), U1.P11 (GND), U1.P13 (GND), U1.R8 (GND), U1.R10 (GND), U1.R12 (GND), U1.R20 (GND), U1.T7 (GND), U1.T9 (GND), U1.T11 (GND), U1.T17 (GND), U1.U4 (GND), U1.U14 (GND), U1.V1 (GND), U1.V11 (GND), U1.V21 (GND), U1.W8 (GND), U1.W18 (GND), U1.Y5 (GND), U1.Y15 (GND), U15.1 (GND); also elsewhere on the board
unnamed: R22.2, U15.4 (PR1)
XGNDadc: C50.2, C105.2, FB2.1, U1.K9 (GNDADC_0); also elsewhere on the board

Notes on the sheet:
see xadc pinout req: UG480 figure 1-2 Vccadc to xvadc Vp, Vn, Vrefp, Vrefn to xgndadc

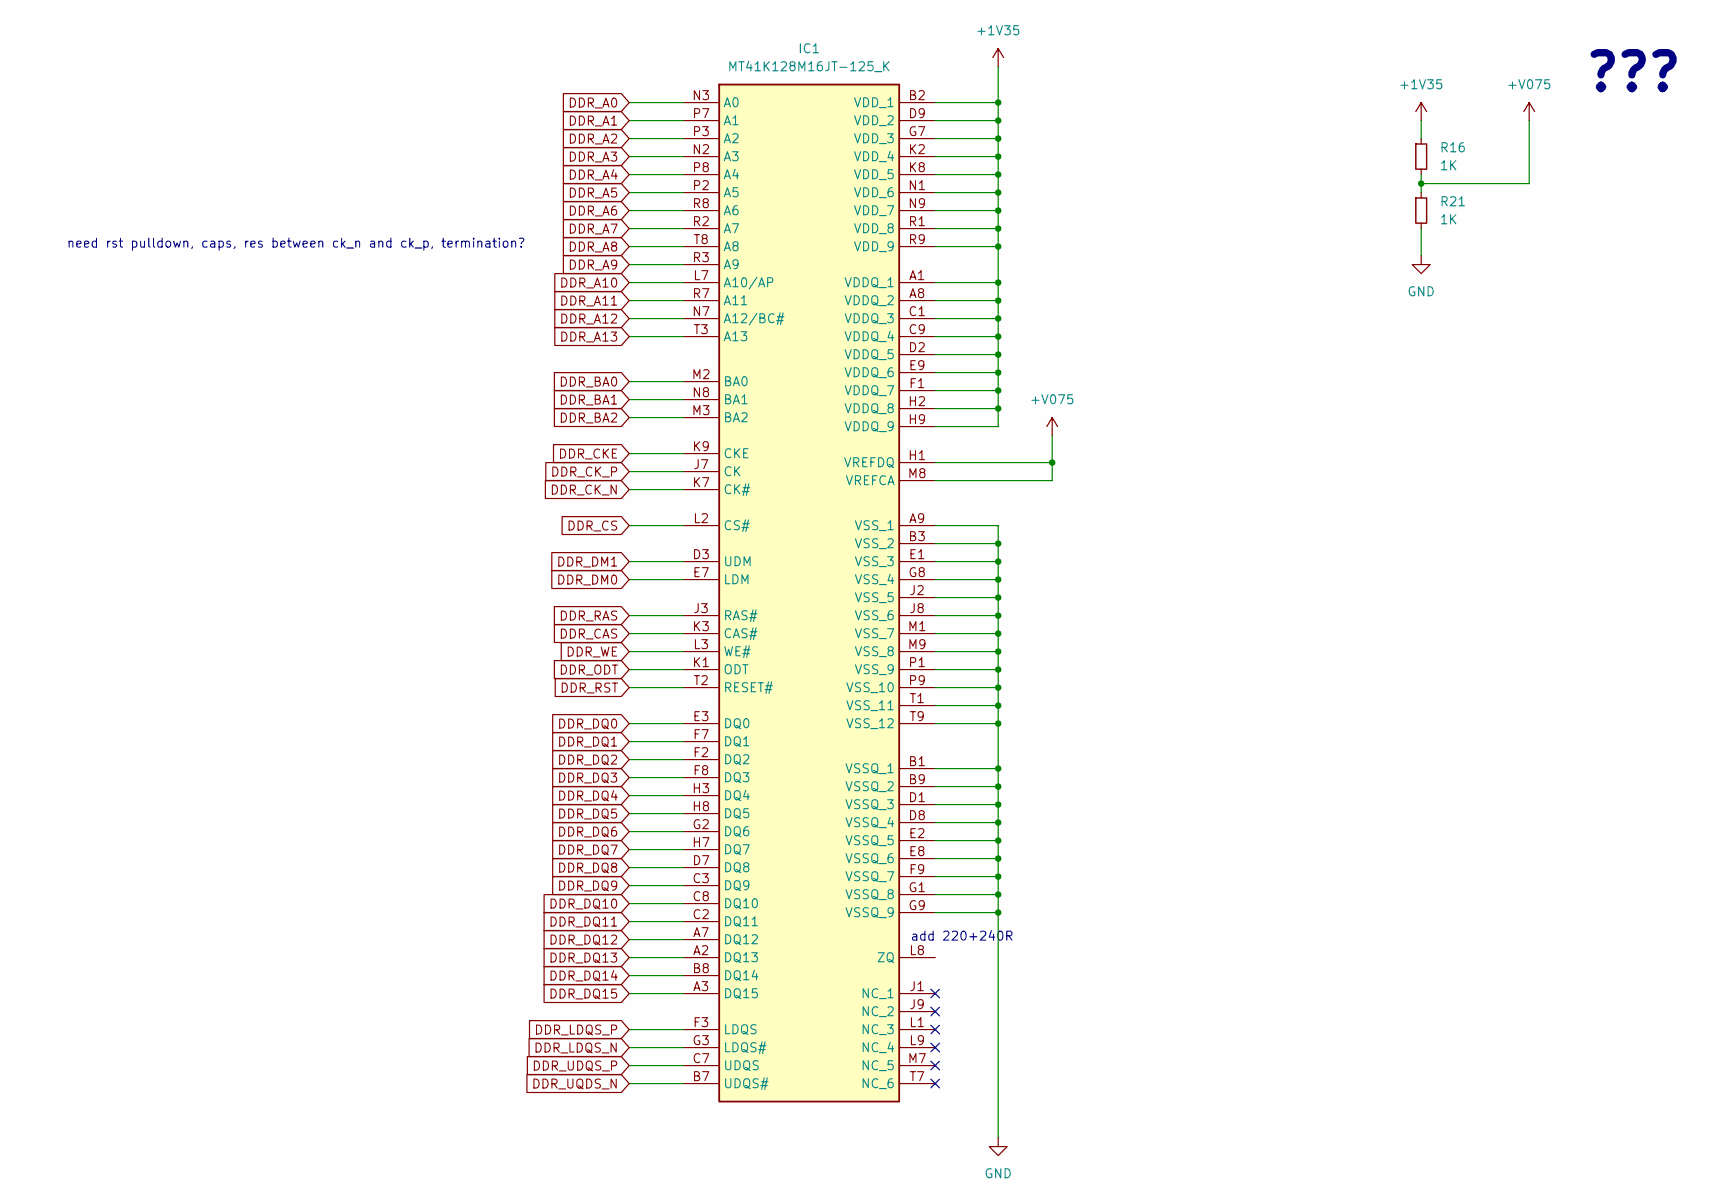
[picture p7: schematic ddr3.kicad_sch]

Parts:
IC1: MT41K128M16JT-125_K; BGA96C80P9X16_800X1400X120; LCSC Part # C36513
R16, R21: 1K; R_0603_1608Metric; LCSC Part # C4410

Connections:
+1V35: IC1.A1 (VDDQ_1), IC1.A8 (VDDQ_2), IC1.B2 (VDD_1), IC1.C1 (VDDQ_3), IC1.C9 (VDDQ_4), IC1.D2 (VDDQ_5), IC1.D9 (VDD_2), IC1.E9 (VDDQ_6), IC1.F1 (VDDQ_7), IC1.G7 (VDD_3), IC1.H2 (VDDQ_8), IC1.H9 (VDDQ_9), IC1.K2 (VDD_4), IC1.K8 (VDD_5), IC1.N1 (VDD_6), IC1.N9 (VDD_7), IC1.R1 (VDD_8), IC1.R9 (VDD_9), R16.1; also elsewhere on the board
+V075: IC1.H1 (VREFDQ), IC1.M8 (VREFCA), R16.2, R21.1
DDR_A0: IC1.N3 (A0); also elsewhere on the board
DDR_A1: IC1.P7 (A1); also elsewhere on the board
DDR_A2: IC1.P3 (A2); also elsewhere on the board
DDR_A3: IC1.N2 (A3); also elsewhere on the board
DDR_A4: IC1.P8 (A4); also elsewhere on the board
DDR_A5: IC1.P2 (A5); also elsewhere on the board
DDR_A6: IC1.R8 (A6); also elsewhere on the board
DDR_A7: IC1.R2 (A7); also elsewhere on the board
DDR_A8: IC1.T8 (A8); also elsewhere on the board
DDR_A9: IC1.R3 (A9); also elsewhere on the board
DDR_A10: IC1.L7 (A10/AP); also elsewhere on the board
DDR_A11: IC1.R7 (A11); also elsewhere on the board
DDR_A12: IC1.N7 (A12/BC#); also elsewhere on the board
DDR_A13: IC1.T3 (A13); also elsewhere on the board
DDR_BA0: IC1.M2 (BA0); also elsewhere on the board
DDR_BA1: IC1.N8 (BA1); also elsewhere on the board
DDR_BA2: IC1.M3 (BA2); also elsewhere on the board
DDR_CAS: IC1.K3 (CAS#); also elsewhere on the board
DDR_CKE: IC1.K9 (CKE); also elsewhere on the board
DDR_CK_N: IC1.K7 (CK#); also elsewhere on the board
DDR_CK_P: IC1.J7 (CK); also elsewhere on the board
DDR_CS: IC1.L2 (CS#); also elsewhere on the board
DDR_DM0: IC1.E7 (LDM); also elsewhere on the board
DDR_DM1: IC1.D3 (UDM); also elsewhere on the board
DDR_DQ0: IC1.E3 (DQ0); also elsewhere on the board
DDR_DQ1: IC1.F7 (DQ1); also elsewhere on the board
DDR_DQ2: IC1.F2 (DQ2); also elsewhere on the board
DDR_DQ3: IC1.F8 (DQ3); also elsewhere on the board
DDR_DQ4: IC1.H3 (DQ4); also elsewhere on the board
DDR_DQ5: IC1.H8 (DQ5); also elsewhere on the board
DDR_DQ6: IC1.G2 (DQ6); also elsewhere on the board
DDR_DQ7: IC1.H7 (DQ7); also elsewhere on the board
DDR_DQ8: IC1.D7 (DQ8); also elsewhere on the board
DDR_DQ9: IC1.C3 (DQ9); also elsewhere on the board
DDR_DQ10: IC1.C8 (DQ10); also elsewhere on the board
DDR_DQ11: IC1.C2 (DQ11); also elsewhere on the board
DDR_DQ12: IC1.A7 (DQ12); also elsewhere on the board
DDR_DQ13: IC1.A2 (DQ13); also elsewhere on the board
DDR_DQ14: IC1.B8 (DQ14); also elsewhere on the board
DDR_DQ15: IC1.A3 (DQ15); also elsewhere on the board
DDR_LDQS_N: IC1.G3 (LDQS#); also elsewhere on the board
DDR_LDQS_P: IC1.F3 (LDQS); also elsewhere on the board
DDR_ODT: IC1.K1 (ODT); also elsewhere on the board
DDR_RAS: IC1.J3 (RAS#); also elsewhere on the board
DDR_RST: IC1.T2 (RESET#); also elsewhere on the board
DDR_UDQS_P: IC1.C7 (UDQS); also elsewhere on the board
DDR_UQDS_N: IC1.B7 (UDQS#); also elsewhere on the board
DDR_WE: IC1.L3 (WE#); also elsewhere on the board
GND: IC1.A9 (VSS_1), IC1.B1 (VSSQ_1), IC1.B3 (VSS_2), IC1.B9 (VSSQ_2), IC1.D1 (VSSQ_3), IC1.D8 (VSSQ_4), IC1.E1 (VSS_3), IC1.E2 (VSSQ_5), IC1.E8 (VSSQ_6), IC1.F9 (VSSQ_7), IC1.G1 (VSSQ_8), IC1.G8 (VSS_4), IC1.G9 (VSSQ_9), IC1.J2 (VSS_5), IC1.J8 (VSS_6), IC1.M1 (VSS_7), IC1.M9 (VSS_8), IC1.P1 (VSS_9), IC1.P9 (VSS_10), IC1.T1 (VSS_11), IC1.T9 (VSS_12), R21.2; also elsewhere on the board

Notes on the sheet:
add 220+240R
???
need rst pulldown, caps, res between ck_n and ck_p, termination?

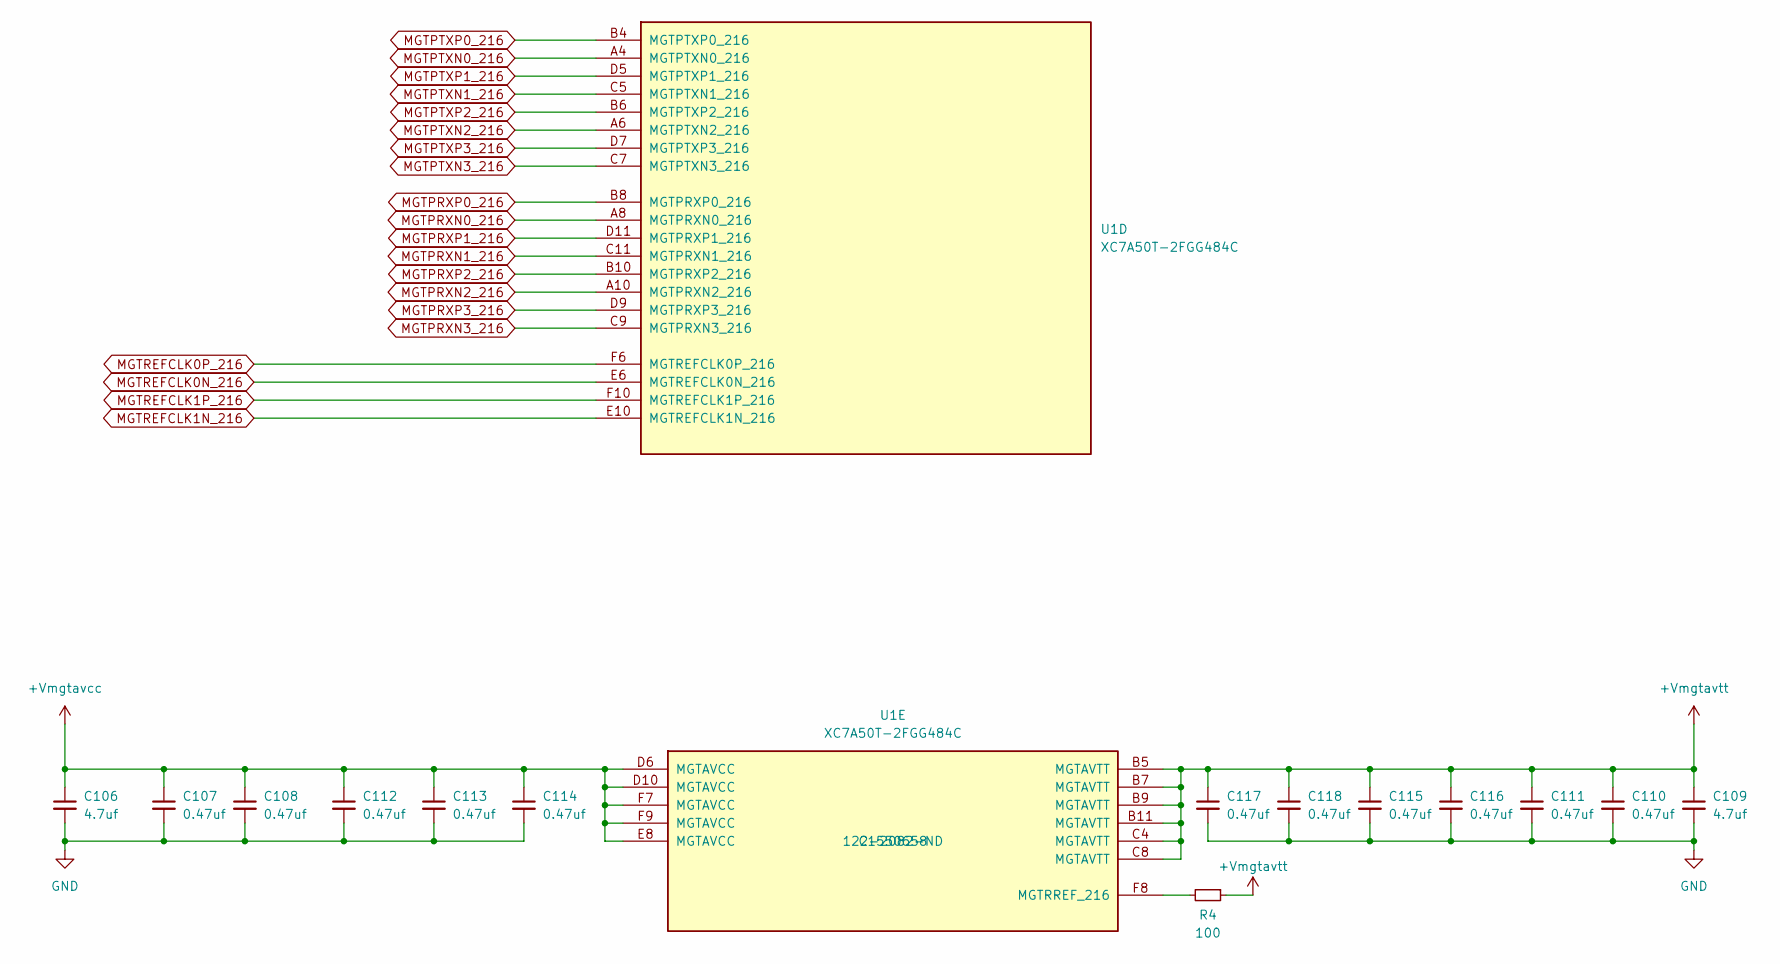
[picture p8: schematic fpga_banks_gtp.kicad_sch]

Parts:
C106, C109: 4.7uf; C_0805_2012Metric; LCSC Part # C1779
C107, C108, C110, C111, C112, C113, C114, C115, C116, C117, C118: 0.47uf; C_0201_0603Metric; LCSC Part # C318543
R4: 100; R_0201_0603Metric; LCSC Part # C270366
U1: XC7A50T-2FGG484C; Xilinx_FGG484; LCSC Part # C1550658

Connections:
+Vmgtavcc: C106.1, C107.1, C108.1, C112.1, C113.1, C114.1, U1.D6 (MGTAVCC), U1.D10 (MGTAVCC), U1.E8 (MGTAVCC), U1.F7 (MGTAVCC), U1.F9 (MGTAVCC); also elsewhere on the board
+Vmgtavtt: C109.1, C110.1, C111.1, C115.1, C116.1, C117.1, C118.1, R4.1, U1.B5 (MGTAVTT), U1.B7 (MGTAVTT), U1.B9 (MGTAVTT), U1.B11 (MGTAVTT), U1.C4 (MGTAVTT), U1.C8 (MGTAVTT); also elsewhere on the board
GND: C106.2, C107.2, C108.2, C109.2, C110.2, C111.2, C112.2, C113.2, C114.2, C115.2, C116.2, C117.2, C118.2; also elsewhere on the board
MGTPRXN0_216: U1.A8 (MGTPRXN0_216); also elsewhere on the board
MGTPRXN1_216: U1.C11 (MGTPRXN1_216); also elsewhere on the board
MGTPRXN2_216: U1.A10 (MGTPRXN2_216); also elsewhere on the board
MGTPRXN3_216: U1.C9 (MGTPRXN3_216); also elsewhere on the board
MGTPRXP0_216: U1.B8 (MGTPRXP0_216); also elsewhere on the board
MGTPRXP1_216: U1.D11 (MGTPRXP1_216); also elsewhere on the board
MGTPRXP2_216: U1.B10 (MGTPRXP2_216); also elsewhere on the board
MGTPRXP3_216: U1.D9 (MGTPRXP3_216); also elsewhere on the board
MGTPTXN0_216: U1.A4 (MGTPTXN0_216); also elsewhere on the board
MGTPTXN1_216: U1.C5 (MGTPTXN1_216); also elsewhere on the board
MGTPTXN2_216: U1.A6 (MGTPTXN2_216); also elsewhere on the board
MGTPTXN3_216: U1.C7 (MGTPTXN3_216); also elsewhere on the board
MGTPTXP0_216: U1.B4 (MGTPTXP0_216); also elsewhere on the board
MGTPTXP1_216: U1.D5 (MGTPTXP1_216); also elsewhere on the board
MGTPTXP2_216: U1.B6 (MGTPTXP2_216); also elsewhere on the board
MGTPTXP3_216: U1.D7 (MGTPTXP3_216); also elsewhere on the board
MGTREFCLK0N_216: U1.E6 (MGTREFCLK0N_216); also elsewhere on the board
MGTREFCLK0P_216: U1.F6 (MGTREFCLK0P_216); also elsewhere on the board
MGTREFCLK1N_216: U1.E10 (MGTREFCLK1N_216); also elsewhere on the board
MGTREFCLK1P_216: U1.F10 (MGTREFCLK1P_216); also elsewhere on the board
unnamed: R4.2, U1.F8 (MGTRREF_216)

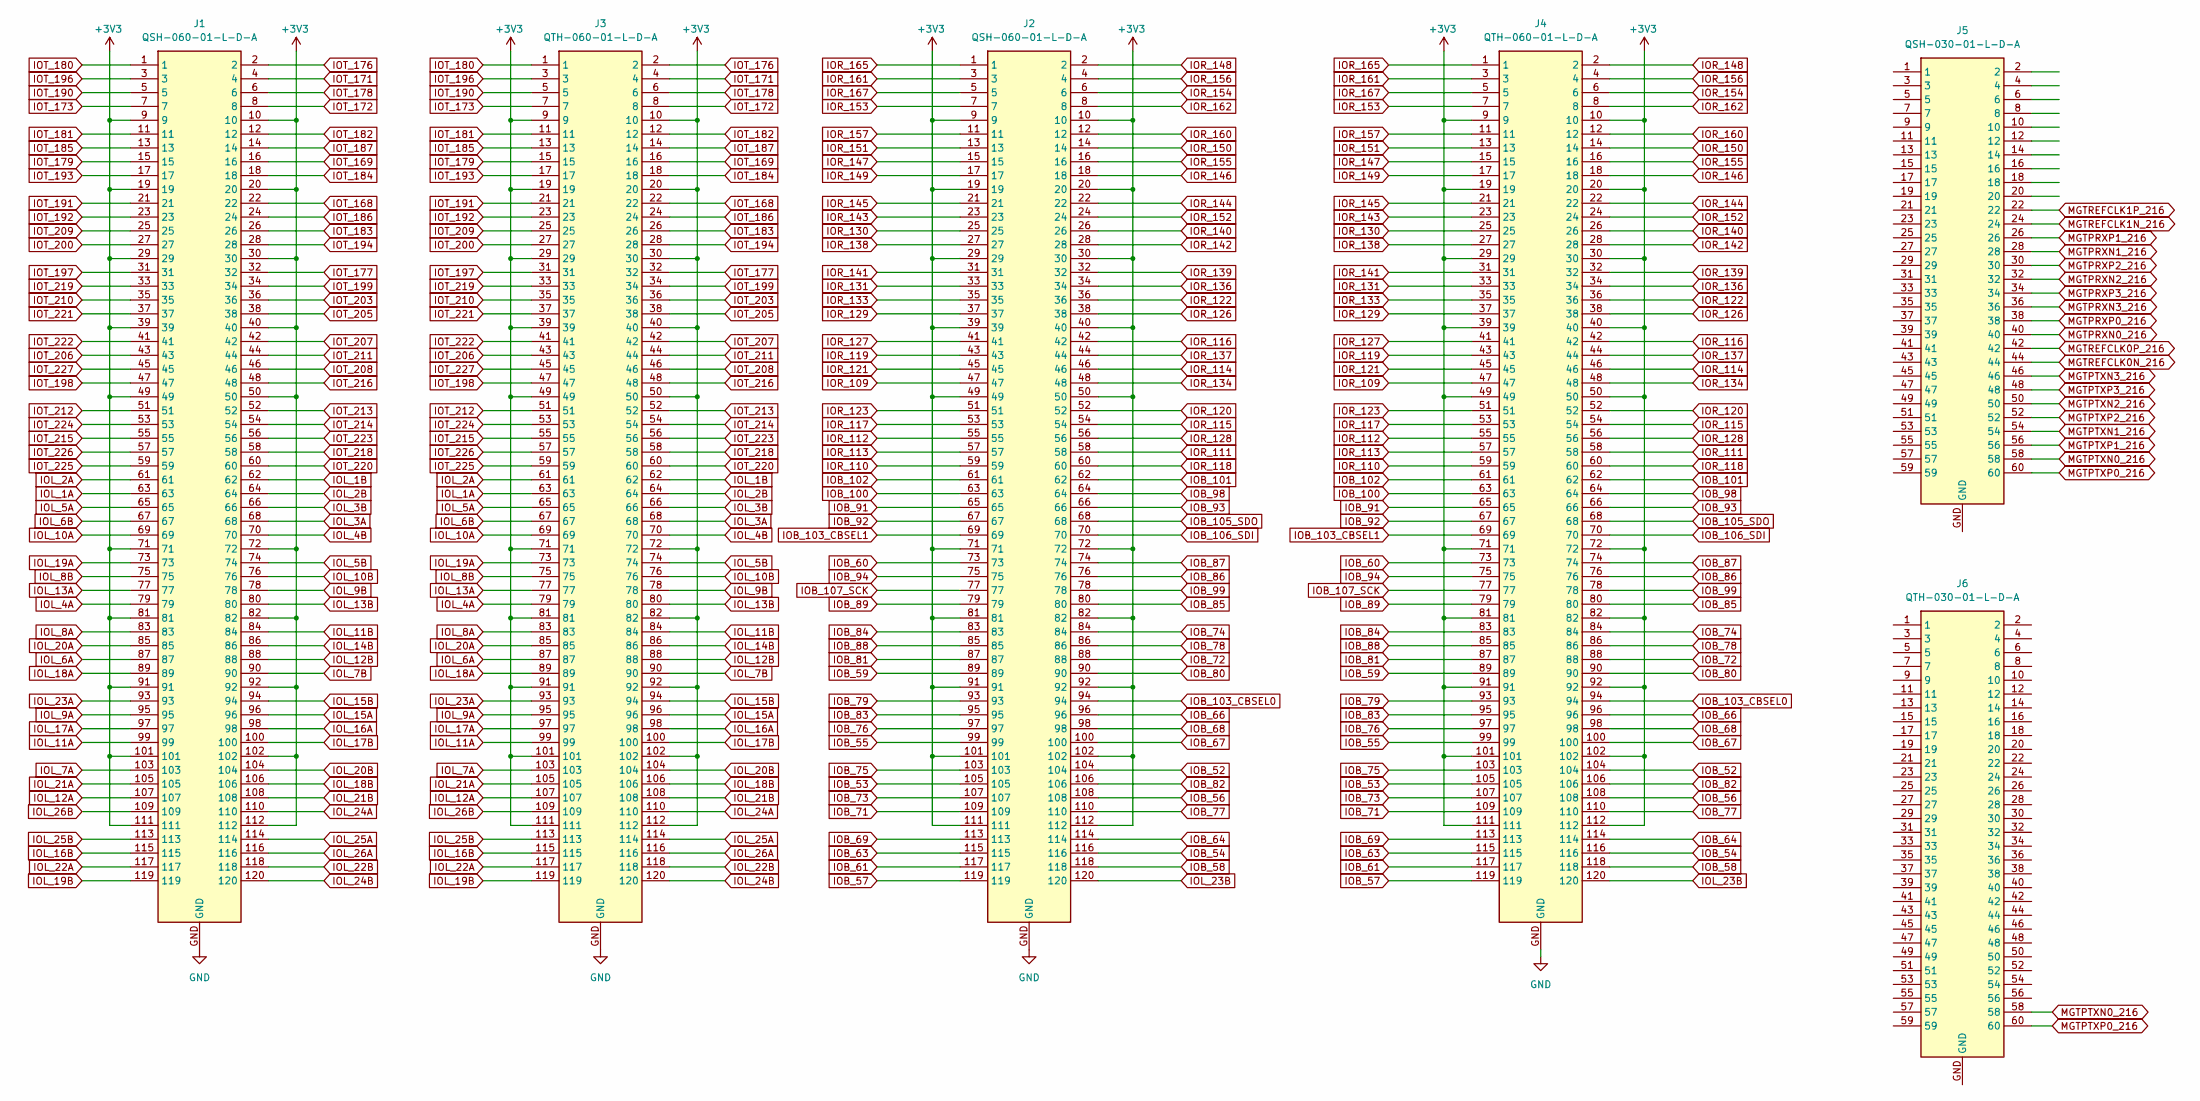
[picture p9: schematic headers.kicad_sch]

Parts:
J1, J2: QSH-060-01-L-D-A; SAMTEC_QSH-060-01-X-D-A
J3, J4: QTH-060-01-L-D-A; SAMTEC_QTH-060-01-X-D-A
J5: QSH-030-01-L-D-A; SAMTEC_QSH-030-01-X-D-A
J6: QTH-030-01-L-D-A; SAMTEC_QTH-030-01-X-D-A

Connections:
+3V3: J1.9, J1.10, J1.19, J1.20, J1.29, J1.30, J1.39, J1.40, J1.49, J1.50, J1.71, J1.72, J1.81, J1.82, J1.91, J1.92, J1.101, J1.102, J1.111, J1.112, J2.9, J2.10, J2.19, J2.20, J2.29, J2.30, J2.39, J2.40, J2.49, J2.50, J2.71, J2.72, J2.81, J2.82, J2.91, J2.92, J2.101, J2.102, J2.111, J2.112, J3.9, J3.10, J3.19, J3.20, J3.29, J3.30, J3.39, J3.40, J3.49, J3.50, J3.71, J3.72, J3.81, J3.82, J3.91, J3.92, J3.101, J3.102, J3.111, J3.112, J4.9, J4.10, J4.19, J4.20, J4.29, J4.30, J4.39, J4.40, J4.49, J4.50, J4.71, J4.72, J4.81, J4.82, J4.91, J4.92, J4.101, J4.102, J4.111, J4.112; also elsewhere on the board
GND: J1.GND, J2.GND, J3.GND, J4.GND; also elsewhere on the board
IOB_52: J2.104, J4.104
IOB_53: J2.105, J4.105
IOB_54: J2.116, J4.116
IOB_55: J2.99, J4.99
IOB_56: J2.108, J4.108
IOB_57: J2.119, J4.119
IOB_58: J2.118, J4.118
IOB_59: J2.89, J4.89
IOB_60: J2.73, J4.73
IOB_61: J2.117, J4.117
IOB_63: J2.115, J4.115
IOB_64: J2.114, J4.114
IOB_66: J2.96, J4.96
IOB_67: J2.100, J4.100
IOB_68: J2.98, J4.98
IOB_69: J2.113, J4.113
IOB_71: J2.109, J4.109
IOB_72: J2.88, J4.88
IOB_73: J2.107, J4.107
IOB_74: J2.84, J4.84
IOB_75: J2.103, J4.103
IOB_76: J2.97, J4.97
IOB_77: J2.110, J4.110
IOB_78: J2.86, J4.86
IOB_79: J2.93, J4.93
IOB_80: J2.90, J4.90
IOB_81: J2.87, J4.87
IOB_82: J2.106, J4.106
IOB_83: J2.95, J4.95
IOB_84: J2.83, J4.83
IOB_85: J2.80, J4.80
IOB_86: J2.76, J4.76
IOB_87: J2.74, J4.74
IOB_88: J2.85, J4.85
IOB_89: J2.79, J4.79
IOB_91: J2.65, J4.65
IOB_92: J2.67, J4.67
IOB_93: J2.66, J4.66
IOB_94: J2.75, J4.75
IOB_98: J2.64, J4.64
IOB_99: J2.78, J4.78
IOB_100: J2.63, J4.63
IOB_101: J2.62, J4.62
IOB_102: J2.61, J4.61
IOB_103_CBSEL0: J2.94, J4.94
IOB_103_CBSEL1: J2.69, J4.69
IOB_105_SDO: J2.68, J4.68
IOB_106_SDI: J2.70, J4.70
IOB_107_SCK: J2.77, J4.77
IOL_1A: J1.63, J3.63
IOL_1B: J1.62, J3.62
IOL_2A: J1.61, J3.61
IOL_2B: J1.64, J3.64
IOL_3A: J1.68, J3.68
IOL_3B: J1.66, J3.66
IOL_4A: J1.79, J3.79
IOL_4B: J1.70, J3.70
IOL_5A: J1.65, J3.65
IOL_5B: J1.74, J3.74
IOL_6A: J1.87, J3.87
IOL_6B: J1.67, J3.67
IOL_7A: J1.103, J3.103
IOL_7B: J1.90, J3.90
IOL_8A: J1.83, J3.83
IOL_8B: J1.75, J3.75
IOL_9A: J1.95, J3.95
IOL_9B: J1.78, J3.78
IOL_10A: J1.69, J3.69
IOL_10B: J1.76, J3.76
IOL_11A: J1.99, J3.99
IOL_11B: J1.84, J3.84
IOL_12A: J1.107, J3.107
IOL_12B: J1.88, J3.88
IOL_13A: J1.77, J3.77
IOL_13B: J1.80, J3.80
IOL_14B: J1.86, J3.86
IOL_15A: J1.96, J3.96
IOL_15B: J1.94, J3.94
IOL_16A: J1.98, J3.98
IOL_16B: J1.115, J3.115
IOL_17A: J1.97, J3.97
IOL_17B: J1.100, J3.100
IOL_18A: J1.89, J3.89
IOL_18B: J1.106, J3.106
IOL_19A: J1.73, J3.73
IOL_19B: J1.119, J3.119
IOL_20A: J1.85, J3.85
IOL_20B: J1.104, J3.104
IOL_21A: J1.105, J3.105
IOL_21B: J1.108, J3.108
IOL_22A: J1.117, J3.117
IOL_22B: J1.118, J3.118
IOL_23A: J1.93, J3.93
IOL_23B: J2.120, J4.120
IOL_24A: J1.110, J3.110
IOL_24B: J1.120, J3.120
IOL_25A: J1.114, J3.114
IOL_25B: J1.113, J3.113
IOL_26A: J1.116, J3.116
IOL_26B: J1.109, J3.109
IOR_109: J2.47, J4.47
IOR_110: J2.59, J4.59
IOR_111: J2.58, J4.58
IOR_112: J2.55, J4.55
IOR_113: J2.57, J4.57
IOR_114: J2.46, J4.46
IOR_115: J2.54, J4.54
IOR_116: J2.42, J4.42
IOR_117: J2.53, J4.53
IOR_118: J2.60, J4.60
IOR_119: J2.43, J4.43
IOR_120: J2.52, J4.52
IOR_121: J2.45, J4.45
IOR_122: J2.36, J4.36
IOR_123: J2.51, J4.51
IOR_126: J2.38, J4.38
IOR_127: J2.41, J4.41
IOR_128: J2.56, J4.56
IOR_129: J2.37, J4.37
IOR_130: J2.25, J4.25
IOR_131: J2.33, J4.33
IOR_133: J2.35, J4.35
IOR_134: J2.48, J4.48
IOR_136: J2.34, J4.34
IOR_137: J2.44, J4.44
IOR_138: J2.27, J4.27
IOR_139: J2.32, J4.32
IOR_140: J2.26, J4.26
IOR_141: J2.31, J4.31
IOR_142: J2.28, J4.28
IOR_143: J2.23, J4.23
IOR_144: J2.22, J4.22
IOR_145: J2.21, J4.21
IOR_146: J2.18, J4.18
IOR_147: J2.15, J4.15
IOR_148: J2.2, J4.2
IOR_149: J2.17, J4.17
IOR_150: J2.14, J4.14
IOR_151: J2.13, J4.13
IOR_152: J2.24, J4.24
IOR_153: J2.7, J4.7
IOR_154: J2.6, J4.6
IOR_155: J2.16, J4.16
IOR_156: J2.4, J4.4
IOR_157: J2.11, J4.11
IOR_160: J2.12, J4.12
IOR_161: J2.3, J4.3
IOR_162: J2.8, J4.8
IOR_165: J2.1, J4.1
IOR_167: J2.5, J4.5
IOT_168: J1.22, J3.22
IOT_169: J1.16, J3.16
IOT_171: J1.4, J3.4
IOT_172: J1.8, J3.8
IOT_173: J1.7, J3.7
IOT_176: J1.2, J3.2
IOT_177: J1.32, J3.32
IOT_178: J1.6, J3.6
IOT_179: J1.15, J3.15
IOT_180: J1.1, J3.1
IOT_181: J1.11, J3.11
IOT_182: J1.12, J3.12
IOT_183: J1.26, J3.26
IOT_184: J1.18, J3.18
IOT_185: J1.13, J3.13
IOT_186: J1.24, J3.24
IOT_187: J1.14, J3.14
IOT_190: J1.5, J3.5
IOT_191: J1.21, J3.21
IOT_192: J1.23, J3.23
IOT_193: J1.17, J3.17
IOT_194: J1.28, J3.28
IOT_196: J1.3, J3.3
IOT_197: J1.31, J3.31
IOT_198: J1.47, J3.47
IOT_199: J1.34, J3.34
IOT_200: J1.27, J3.27
IOT_203: J1.36, J3.36
IOT_205: J1.38, J3.38
IOT_206: J1.43, J3.43
IOT_207: J1.42, J3.42
IOT_208: J1.46, J3.46
IOT_209: J1.25, J3.25
IOT_210: J1.35, J3.35
IOT_211: J1.44, J3.44
IOT_212: J1.51, J3.51
IOT_213: J1.52, J3.52
IOT_214: J1.54, J3.54
IOT_215: J1.55, J3.55
IOT_216: J1.48, J3.48
IOT_218: J1.58, J3.58
IOT_219: J1.33, J3.33
IOT_220: J1.60, J3.60
IOT_221: J1.37, J3.37
IOT_222: J1.41, J3.41
IOT_223: J1.56, J3.56
IOT_224: J1.53, J3.53
IOT_225: J1.59, J3.59
IOT_226: J1.57, J3.57
IOT_227: J1.45, J3.45
MGTPRXN0_216: J5.40; also elsewhere on the board
MGTPRXN1_216: J5.28; also elsewhere on the board
MGTPRXN2_216: J5.32; also elsewhere on the board
MGTPRXN3_216: J5.36; also elsewhere on the board
MGTPRXP0_216: J5.38; also elsewhere on the board
MGTPRXP1_216: J5.26; also elsewhere on the board
MGTPRXP2_216: J5.30; also elsewhere on the board
MGTPRXP3_216: J5.34; also elsewhere on the board
MGTPTXN0_216: J5.58, J6.58; also elsewhere on the board
MGTPTXN1_216: J5.54; also elsewhere on the board
MGTPTXN2_216: J5.50; also elsewhere on the board
MGTPTXN3_216: J5.46; also elsewhere on the board
MGTPTXP0_216: J5.60, J6.60; also elsewhere on the board
MGTPTXP1_216: J5.56; also elsewhere on the board
MGTPTXP2_216: J5.52; also elsewhere on the board
MGTPTXP3_216: J5.48; also elsewhere on the board
MGTREFCLK0N_216: J5.44; also elsewhere on the board
MGTREFCLK0P_216: J5.42; also elsewhere on the board
MGTREFCLK1N_216: J5.24; also elsewhere on the board
MGTREFCLK1P_216: J5.22; also elsewhere on the board

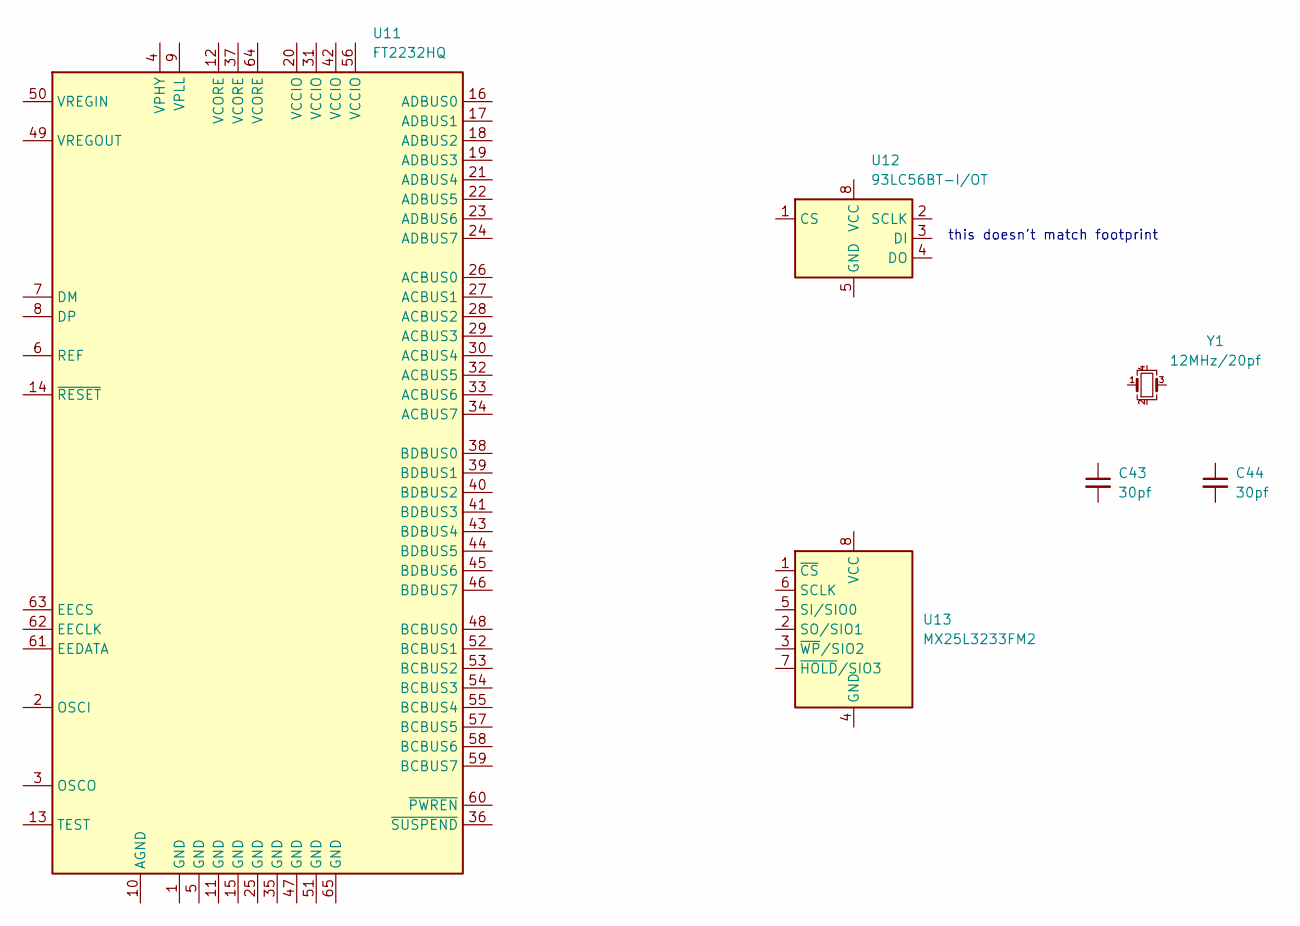
[picture p10: schematic programmer.kicad_sch]

Parts:
C43, C44: 30pf; C_0603_1608Metric; LCSC Part # C1658
U11: FT2232HQ; LCSC Part # C193662
U12: 93LC56BT-I/OT; SOT-23-6; LCSC Part # C190271
U13: MX25L3233FM2; SOIC-8_5.3x5.3mm_P1.27mm; LCSC Part # C190802
Y1: 12MHz/20pf; Crystal_SMD_3225-4Pin_3.2x2.5mm; LCSC Part # C9002

Notes on the sheet:
this doesn't match footprint

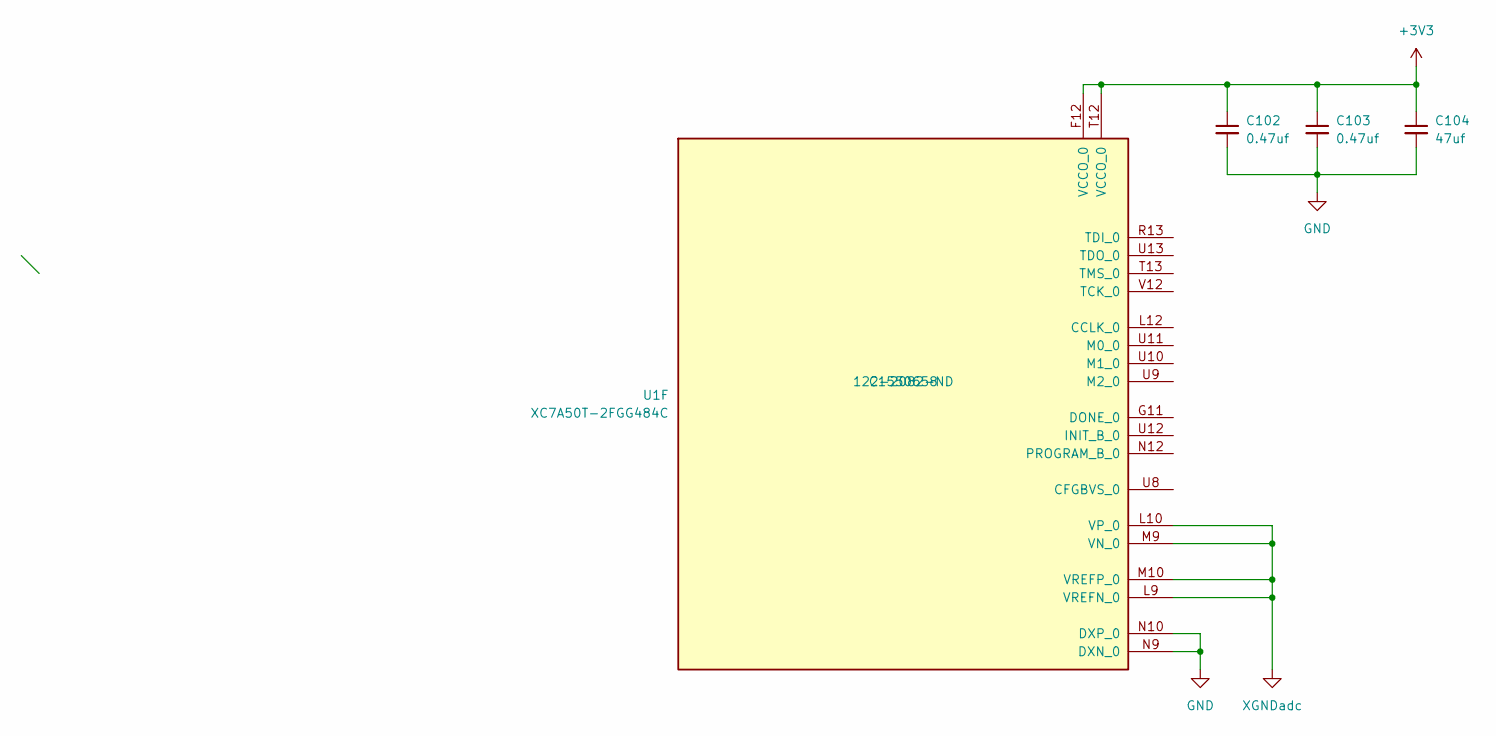
[picture p11: schematic fpga_config.kicad_sch]

Parts:
C102, C103: 0.47uf; C_0201_0603Metric; LCSC Part # C318543
C104: 47uf; C_1206_3216Metric; LCSC Part # C96123
U1: XC7A50T-2FGG484C; Xilinx_FGG484; LCSC Part # C1550658

Connections:
+3V3: C102.1, C103.1, C104.1, U1.F12 (VCCO_0), U1.T12 (VCCO_0); also elsewhere on the board
GND: C102.2, C103.2, C104.2, U1.N9 (DXN_0), U1.N10 (DXP_0); also elsewhere on the board
XGNDadc: U1.L9 (VREFN_0), U1.L10 (VP_0), U1.M9 (VN_0), U1.M10 (VREFP_0); also elsewhere on the board

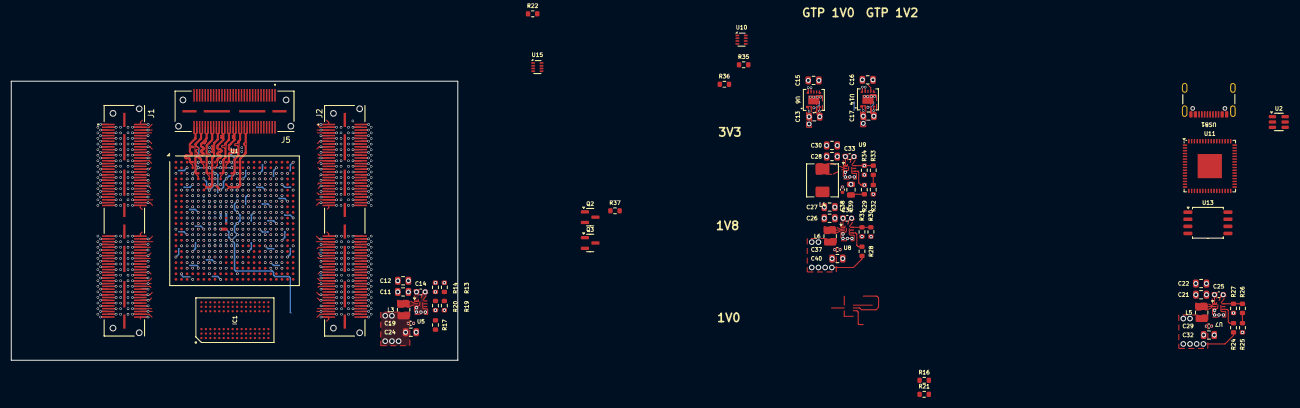
[picture p12: board aup.kicad_pcb from above]

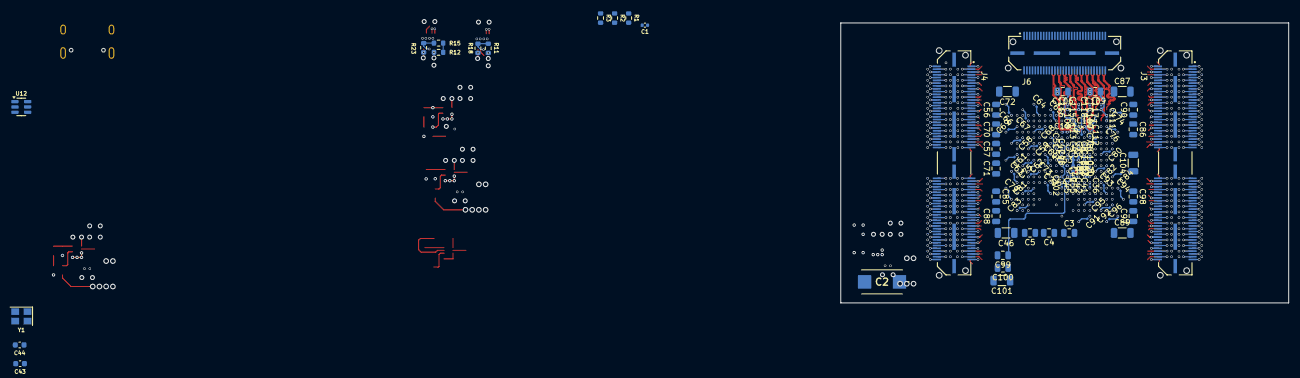
[picture p13: board aup.kicad_pcb from below]

Board: 8 copper layers, 80.0 x 50.0 mm, 179 parts (110 on the bottom side), 313 nets.
