pbozeman/artix-unplugged/(commit log)

2025-04-15 add kicad-base
2025-04-15 Add power design doc
2025-04-16 External power with usb and barrel jack
    [aup.kicad_pcb, aup.kicad_sch, ext_power.kicad_sch]
2025-04-16 Add 5v regulator to external power portion
    [aup.kicad_sch, ext_power.kicad_sch, power_reg.kicad_sch]
2025-04-17 Start of fpga voltage rails. Added 1v0/vccint
    [ext_power.kicad_sch, power_reg.kicad_sch]
2025-04-18 Finished voltage rail schematic
    [ext_power.kicad_sch, power_reg.kicad_sch]
2025-04-18 Added symbols for the major components
    It should be possible to do a first pass placement of ICs on the pcb as
    a rough fit check.
    Most imported footprints are still missing models.
    [aup.kicad_pcb, aup.kicad_sch, ddr3.kicad_sch, ethernet.kicad_sch, ext_power.kicad_sch, fpga_banks.kicad_sch, fpga_config.kicad_sch, fpga_power.kicad_sch]
2025-04-18 Initial layout for Vccint
    [aup.kicad_pcb, fpga_banks.kicad_sch, fpga_power.kicad_sch, power_reg.kicad_sch]
2025-04-18 Rough high level layout plan
    [aup.kicad_pcb]
2025-04-18 ADC vref notes
2025-04-18 Redo high level layout for, hopefully, better power routing
    [aup.kicad_pcb]
2025-04-19 Update voltage rail decisions
2025-04-19 First pass on upper voltage rails
    [aup.kicad_pcb, ext_power.kicad_sch, power_reg.kicad_sch]
2025-04-19 Minor drc fixes
    [aup.kicad_pcb, power_reg.kicad_sch]
2025-04-19 First pass on lower rails
    [aup.kicad_pcb, ext_power.kicad_sch, power_reg.kicad_sch]
2025-04-19 Fix L1 footprint and add reg and ftdi models
    [aup.kicad_pcb, programmer.kicad_sch]
2025-04-19 Update footprints and 3d models. All render
    [aup.kicad_pcb, ethernet.kicad_sch, ext_power.kicad_sch, fpga_banks.kicad_sch, power_reg.kicad_sch]
2025-04-19 Relative path fixes
    [aup.kicad_pcb, ext_power.kicad_sch, fpga_config.kicad_sch, fpga_power.kicad_sch, power_reg.kicad_sch]
2025-04-20 Improve FB nets for lower EMI. Route 5V out to regs
    [aup.kicad_pcb]
2025-04-23 Update rail switch decision
2025-04-23 Add some todo's on schematic. Add vias to fpga
    [aup.kicad_pcb, ext_power.kicad_sch, fpga_power.kicad_sch, power_reg.kicad_sch]
2025-04-23 Redid bga vias
    [aup.kicad_pcb]
2025-04-23 Start to add net class color
    [aup.kicad_pcb, ext_power.kicad_sch, fpga_power.kicad_sch, power_reg.kicad_sch]
2025-04-23 Add power doc notes for GTA
2025-04-23 Add netnames for rails
    [aup.kicad_pcb, ext_power.kicad_sch, fpga_config.kicad_sch, fpga_power.kicad_sch, power_reg.kicad_sch]
2025-04-23 Use TPS2116DRLR for Vin mux
    [ext_power.kicad_sch]
2025-04-23 Start of regulator rework
    [aup.kicad_pcb, ext_power.kicad_sch, fpga_power.kicad_sch, power_reg.kicad_sch]
2025-04-23 GTP 1.0 and 1.2 LDOs routed
    [aup.kicad_pcb, fpga_power.kicad_sch, power_reg.kicad_sch]
2025-04-24 Recovered 1v35
    [aup.kicad_pcb, fpga_power.kicad_sch, power_reg.kicad_sch]
2025-04-25 Cleanup power layout
    [aup.kicad_pcb, ext_power.kicad_sch, fpga_banks.kicad_sch, fpga_power.kicad_sch, power_reg.kicad_sch]
2025-04-25 Very rough assigment for DDR to banks
    [aup.kicad_pcb, ddr3.kicad_sch, fpga_banks.kicad_sch]
2025-04-26 All rails assigned net classes
    [aup.kicad_pcb, ddr3.kicad_sch, ext_power.kicad_sch, fpga_banks.kicad_sch, fpga_power.kicad_sch, power_reg.kicad_sch]
2025-04-26 IO bank netclass assignments
    [aup.kicad_pcb, fpga_banks.kicad_sch]
2025-04-27 Align fpga in daughter area
    [aup.kicad_pcb, fpga_banks.kicad_sch]
2025-04-27 Switch to 50 pin sockets
    [aup.kicad_pcb, ddr3.kicad_sch, ext_power.kicad_sch, fpga_banks.kicad_sch, fpga_power.kicad_sch, headers.kicad_sch, power_reg.kicad_sch]
2025-04-28 Various explorations of layout
    The pcb file is a mess with options. Saving this in a branch
    to revisit it after interim layout.
    [aup.kicad_pcb, ddr3.kicad_sch, ext_power.kicad_sch, fpga_banks.kicad_sch, fpga_power.kicad_sch, power_reg.kicad_sch]
2025-05-06 Switch to QSH-60
    [aup.kicad_pcb, ddr3.kicad_sch, ext_power.kicad_sch, fpga_banks.kicad_sch, fpga_power.kicad_sch, headers.kicad_sch, power_reg.kicad_sch]
2025-06-04 Misc updates - too hard to see in a diff after a delay
    [aup.kicad_pcb, aup.kicad_sch, ddr3.kicad_sch, ext_power.kicad_sch, fpga_banks.kicad_sch, fpga_power.kicad_sch, power_reg.kicad_sch]
2025-06-04 Planning upsized layout
    [aup.kicad_pcb]
2025-06-05 More upsized planning
    [aup.kicad_pcb, aup.kicad_sch, ddr3.kicad_sch, ext_power.kicad_sch, fpga_banks.kicad_sch, fpga_power.kicad_sch, power_reg.kicad_sch]
2025-06-05 Add upper connector
    [aup.kicad_pcb, ddr3.kicad_sch, ext_power.kicad_sch, fpga_banks.kicad_sch, fpga_config.kicad_sch, fpga_power.kicad_sch, headers.kicad_sch, power_reg.kicad_sch]
2025-06-07 Add capacitor requirements
2025-06-07 Add hierarchical sheets for banks and add caps.
    There are some stale sheets in this commit, but I don't want to delete
    an active one accidentally. Save them all for now, and then go back and
    clean them up.
    [aup.kicad_pcb, aup.kicad_sch, ddr3.kicad_sch, fpga_banks_13_14.kicad_sch, fpga_banks_14_15_adj.kicad_sch, fpga_banks_15_16_adj.kicad_sch, fpga_banks_34_35.kicad_sch, fpga_banks_gtp.kicad_sch]
2025-06-07 Added more passives
    [aup.kicad_pcb, fpga_config.kicad_sch, fpga_power.kicad_sch]
2025-06-08 Switch 0.47uf caps under bga to 0201
    [aup.kicad_pcb, ddr3.kicad_sch, fpga_banks_13_14.kicad_sch, fpga_banks_15_16_adj.kicad_sch, fpga_banks_34_35.kicad_sch, fpga_banks_gtp.kicad_sch, fpga_config.kicad_sch, fpga_power.kicad_sch]
2025-06-08 Add GTP passives
    [aup.kicad_pcb, ddr3.kicad_sch, fpga_banks_13_14.kicad_sch, fpga_banks_15_16_adj.kicad_sch, fpga_banks_34_35.kicad_sch, fpga_banks_gtp.kicad_sch, power_reg.kicad_sch]
2025-06-09 Start working out GTP diff pair routing
    [aup.kicad_pcb, ddr3.kicad_sch, fpga_banks_13_14.kicad_sch, fpga_banks_15_16_adj.kicad_sch, fpga_banks_34_35.kicad_sch, fpga_banks_gtp.kicad_sch, headers.kicad_sch, power_reg.kicad_sch]
2025-06-09 GTP diff pairs routed, but not tuned
    [aup.kicad_pcb, fpga_banks_gtp.kicad_sch, headers.kicad_sch]
2025-06-09 Mid GTP tuning
    [aup.kicad_pcb]
2025-06-09 GTP left side tuned
    [aup.kicad_pcb]
2025-06-10 Initial GTP tuning
    [aup.kicad_pcb]
